DeniseViltes/dce-g5-proyecto_integrador/Checkpoint 2/DCE - PCB - v1/PLACA.jpeg

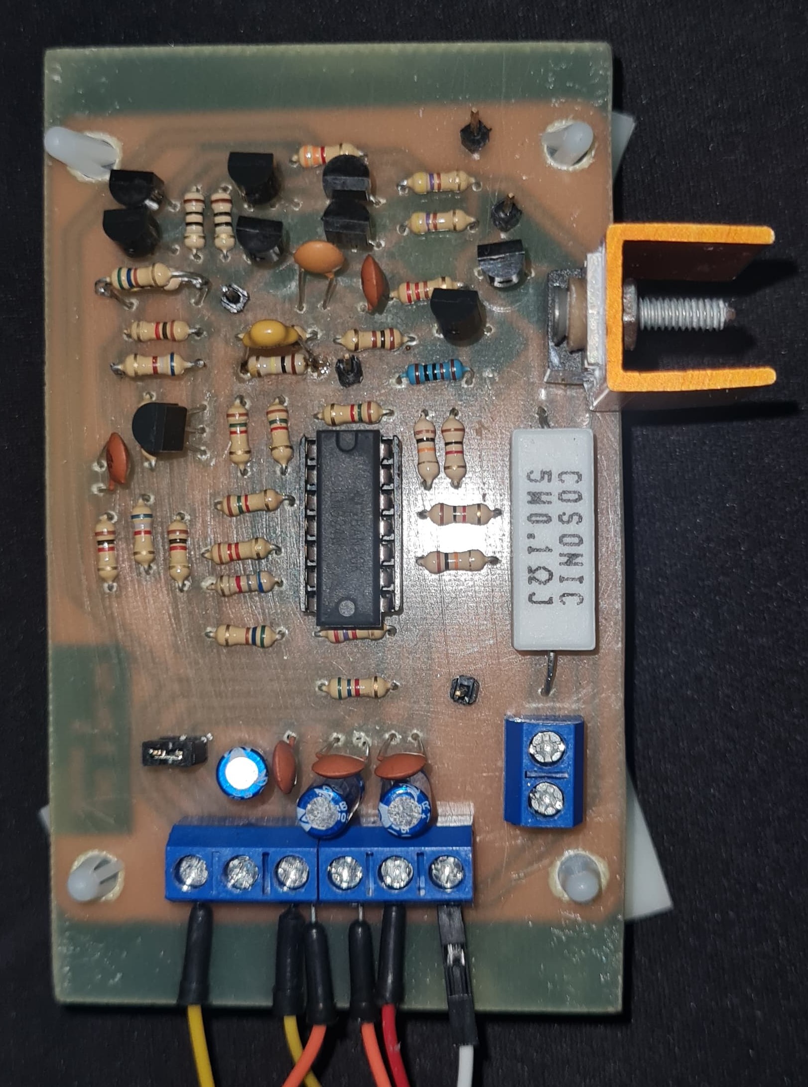
Checkpoint 2/DCE - PCB - v1/PLACA.jpeg
