DeniseViltes/dce-g5-proyecto_integrador/Checkpoint 2/Imagenes/pcb_front.png

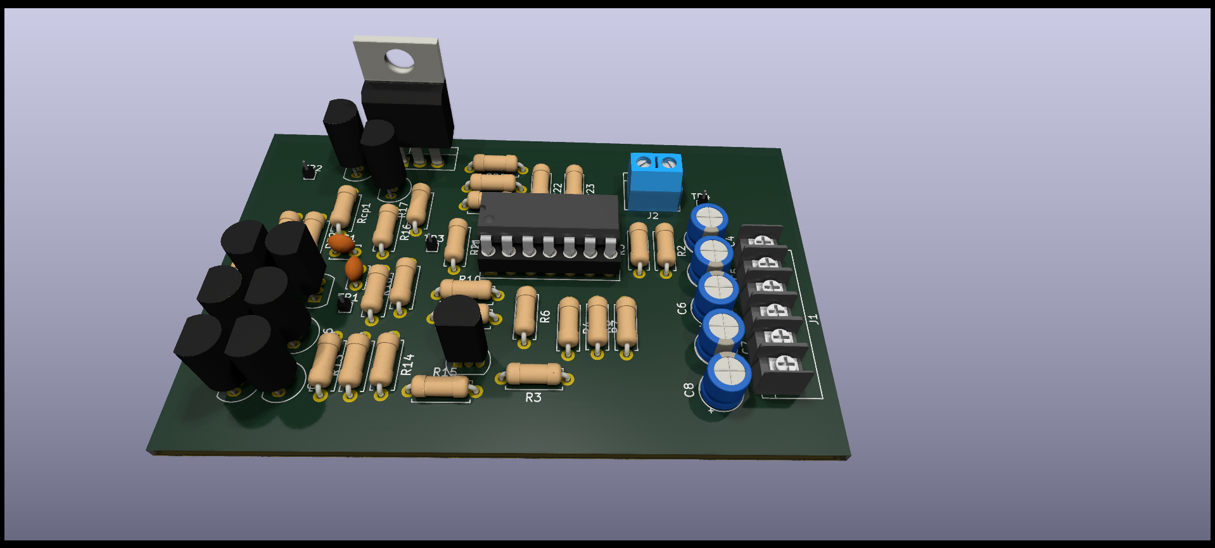
Checkpoint 2/Imagenes/pcb_front.png
