DeniseViltes/dce-g5-proyecto_integrador/README.md

# Proyecto de diseño: Sistema de alimentación para aplicaciones industriales y automotrices
>[!TIP]
>holaa
## Grupo 5
