DeniseViltes/dce-g5-proyecto_integrador/Checkpoint 1/Checkpoint_1_DCE.pdf

TA138 - Diseño de Circuitos Electrónicos | UBA - Facultad de Ingeniería

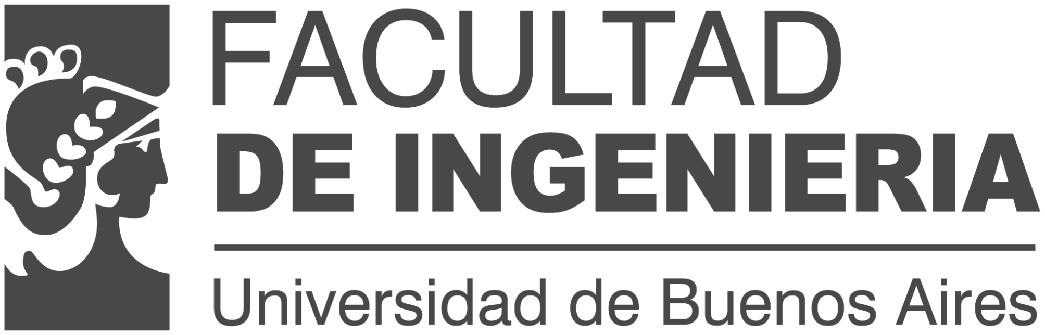
[picture p3: figure]

Departamento de Electronica ´
2

### do cuatrimestre de 2024

### Taller de Diseño de Circuitos Electrónicos (TA138) Checkpoint 1

Grupo | Alumno | Padrón | Mail

5

Diógenes Cornejo Zuviría | 106413 | dcornejoz@fi.uba.ar
Sebastián Ezequiel García | 103780 | sebgarcia@fi.uba.ar
Joaquín Mellibovsky | 103815 | jmellibovsky@fi.uba.ar
Denise Oriana Viltes | 106943 | dviltes@fi.uba.ar

TA138 - Diseño de Circuitos Electrónicos | UBA - Facultad de Ingeniería

## 1. Diseño del circuito

### 1.1. Especificaciones generales

La premisa principal del Trabajo Práctico es diseñar un circuito que se lo alimente con un amplio rango de tensiones de entrada pero que la salida sea de 5 V o 3,3 V según se seleccione. Además de este requisito para la tensión de salida, la corriente debe encontrarse siempre entre los 500 mA y los 750 mA. Las demás especificaciones se presentarán a medida que se desarrolle el circuito para cumplirlas.

En la figura 1 se muestra el diagrama en bloques del circuito a diseñar. En esta entrega nos enfocaremos en el diseño y el esquemático del PCB del bloque LDO.

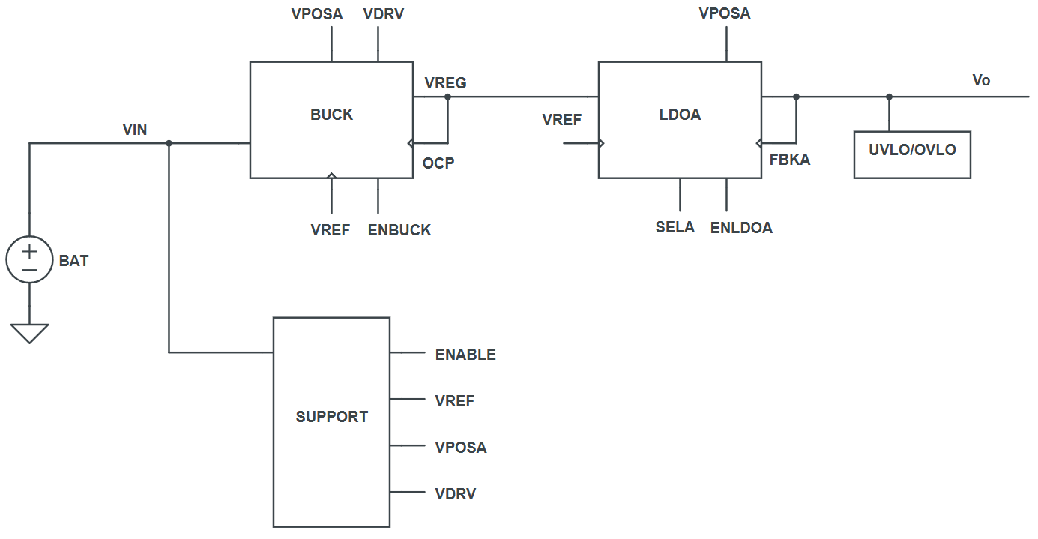
[picture p4: figure]

Figura 1: Diagrama en bloques funcionales del circuito a diseñar.

El bloque LDO recibe seis tensiones:

Vreg: Tensión de alimentación de los transistores del par diferencial, carga activa, fuente espejo y de paso.

Vref : Tensión de entrada al par diferencial.

VPOSA: Tensión de alimentación de los amplificadores operacionales.

2

TA138 - Diseño de Circuitos Electrónicos | UBA - Facultad de Ingeniería

SELA: Tensión de selección de la salida. Cuando está encendida, la salida es de 5 V, mientras que cuando está apagada es de 3,3 V.

FBKA: Realimentación mediante la implementación de un foldback.

ENLDOA: Tensión de encendido del bloque LDO.

El diagrama en bloques del LDO se muestra en la figura 2. En este dibujo los bloques de Muestreo de Corriente, Sumador y Comparador corresponden al foldback. A su vez, éstos y el feedback son todos juntos la realimentación.

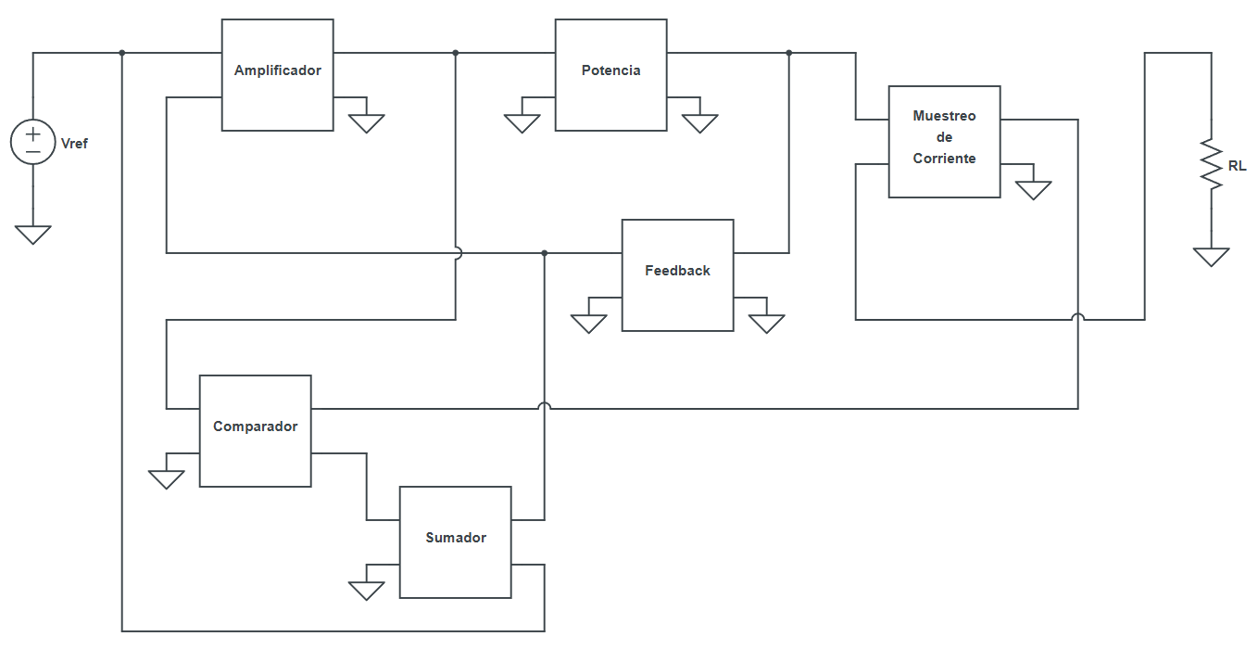
[picture p5: figure]

Figura 2: Diagrama en bloques del LDO.

### 1.2. Análisis de bloques

### 1.2.1. Par diferencial

En esta etapa se busca obtener un circuito estable con desapareamientos mínimos, logrando a su vez la mayor amplificación posible. En principio se parte de la idea de tener los transistores perfectamente apareados por lo que al momento de elegir los transistores, se buscan complementarios NPN-PNP.

Ya que la siguiente etapa (1.2.2) tiene como máximo ganancia unitaria, se debe

buscar maximizar la ganancia en esta etapa. Para lograr esto, en vez de utilizar

3

TA138 - Diseño de Circuitos Electrónicos | UBA - Facultad de Ingeniería

carga resistiva en cada rama del diferencial, se opta por agregar una carga activa, en este caso, una fuente espejo simple. Con esta modificación se logra aumentar la resistencia de salida del par diferencial, e incluso, mejorar el apareamiento del circuito al imponer la misma corriente en ambas ramas. Teniendo esto en cuenta, se buscan transistores con una VA alta (mejorando así la ro), y un β grande para lograr

maximizar la amplificación del par diferencial para la configuración elegida.

Siguiendo la misma línea de pensamiento, con el fin de obtener un circuito más estable, se polariza el diferencial con una fuente de corriente. Utilizando una fuente espejo simple que implica una mayor impedancia, se logra que mejore la relación de rechazo de modo común, sin afectar la ganancia del diferencial.

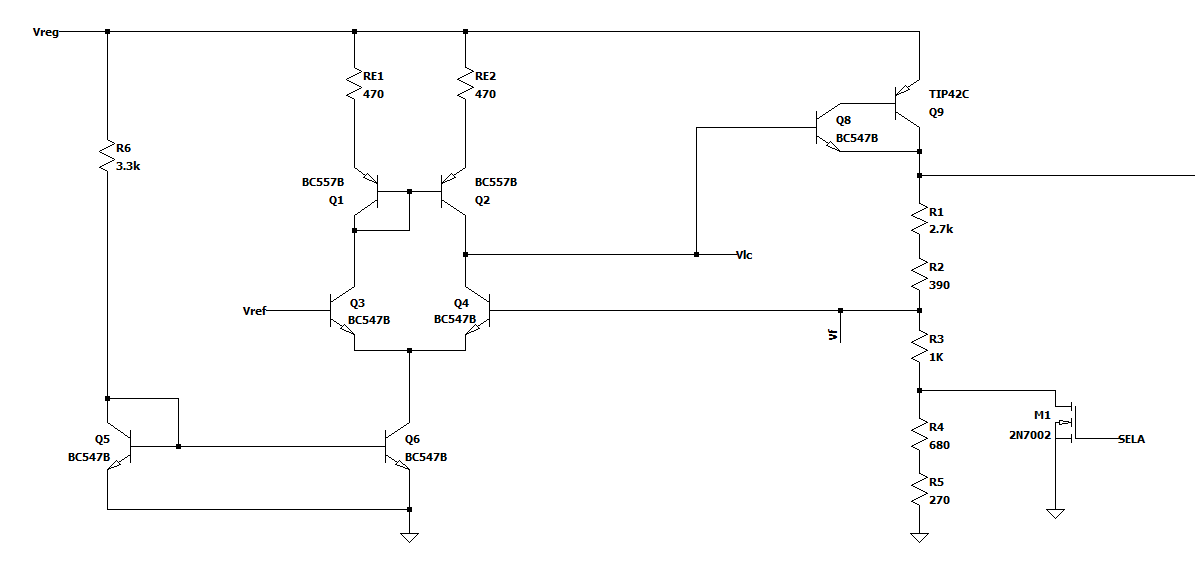
[picture p6: figure]

Figura 3: Bloque amplificador del circuito.

### 1.2.2. Etapa de potencia

A la salida single ended del par diferencial se conecta un par de transistores de paso en configuración cuasi-darlington tipo N. Para esta etapa se utiliza un transistor NPN TIP41C y uno PNP TIP42C. Estos transistores tienen la ventaja de tener una tensión de Early (VA) muy alta, lo cual implica que la tensión VCE varía muy poco con

la corriente como se ve en la figura 4, permitiendo entregarle la corriente necesaria a la carga sin variar la tensión de salida.

4

TA138 - Diseño de Circuitos Electrónicos | UBA - Facultad de Ingeniería

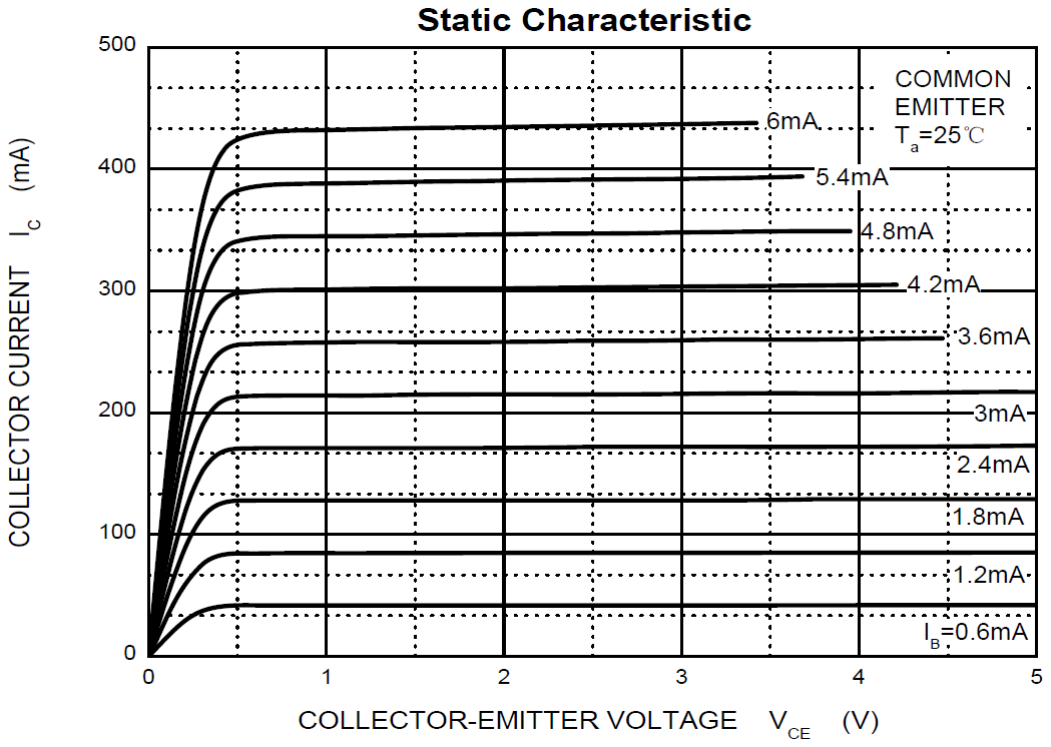
[picture p7: figure]

Figura 4: Curva de IC respecto de V ce para los transistores TIP41 y TIP42.

En cuanto a la configuración, se opta por un Darlington ya que a la salida de este regulador se espera una corriente de trabajo de 500 mA, pero en la salida del par diferencial se obtiene una corriente mucho menor. Esta configuración permite aumentar la corriente de salida del par diferencia β

2 veces.

### 1.2.3. Bloque realimentador

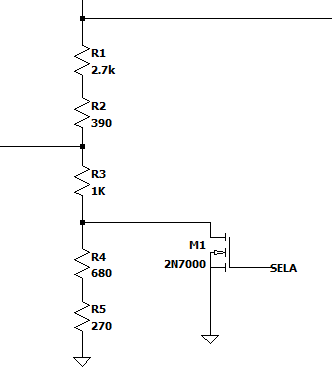
[picture p8: figure]

Figura 5: Bloque de realimentación.

A la salida del transistor de potencia, además de la carga y el bloque controlador de corriente, se coloca un divisor resistivo que muestrea parte de la tensión de salida

5

TA138 - Diseño de Circuitos Electrónicos | UBA - Facultad de Ingeniería

y la suma a la entrada del par diferencial. Idealmente el divisor resistivo debe lograr que se sume una tensión lo más parecida posible a Vref . Esta configuración cuenta con un N-MOSFET que se encarga de adaptar la impedancia para obtener 3,3 V o 5 V según corresponda. Cuando la entrada SELA del LDO supera la tensión VT

∼= 1 V

del transistor, éste entra en saturación y habilita un camino de menor impedancia que los resistores.

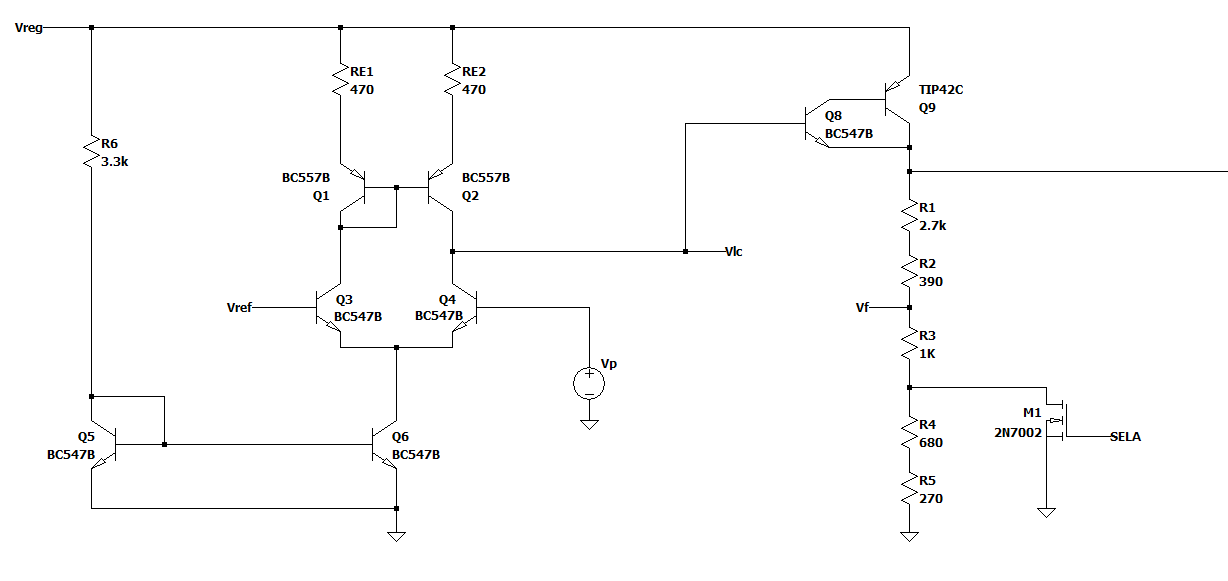
[picture p9: figure]

Figura 6: Esquemático del calculo teórico de la ganancia a lazo abierto a.

Dado entonces que el amplificador está realimentado, la ganancia del mismo a lazo cerrado va a estar dada por la siguiente ecuación:

A =

a
1 + a · f

Realizando los cálculos teóricos la ganancia del par diferencial se puede expresar como:

Para Vo = 3,3 V : avd =

gm4 · [ro2//(rπDar + βDar · (5 kΩ//RL)] 2

Para Vo = 5 V : avd =

gm4 · (ro2//(rπDar + βDar · (4,09 kΩ//RL)] 2

6

TA138 - Diseño de Circuitos Electrónicos | UBA - Facultad de Ingeniería

Se ve que la ganancia por lo tanto depende del valor de RL. En el mejor de los casos RL → ∞, es decir, se abre el circuito. Además, como βdar es muy grande (aproximadamente 4000), mientras el LDO regula tensión la ganancia a lazo abierto

es igual para ambas tensiones de salida.

avd ∼=

gm4 · ro2
2

Considerando los siguientes valores de reposo, los parámetros de señal del amplificador diferencial y del transistor de paso resultan:

Parámetros de Señal

| Icq | gm | rπ | ro
Q1,2,3,4 | 0,85 mA | 34 mA V | 8,5 kΩ | 118 kΩ
Q5,6 | 1,7 mA | 68 mA V | 4,2 kΩ | 59 kΩ

Con estos valores y teniendo en cuenta que la ganancia de la etapa de potencia es aproximadamente unitaria (por su configuración equivalente en colector común) la

ganancia del LDO sin realimentar es:

av = 2006

Cuando la tensión SELA está desactivada (Vo = 3,3 V) la ganancia del bloque

realimentador está dada por el siguiente divisor resistivo:

f =

Vf
Vo

=

270 Ω + 680 Ω + 1 kΩ
270 Ω + 680 Ω + 1 kΩ + 390 Ω + 2,7 kΩ = 0,39

a · f = 2006 · 0, 39 = 782

En cambio, cuando la tensión SELA se activa (Vo = 5 V), se habilita el MOSFET pasa a actuar en tríodo (por la baja corriente que lo circula), por lo que su caída de tensión (VDS) es muy pequeña y resulta aproximadamente el siguiente divisor:

7

TA138 - Diseño de Circuitos Electrónicos | UBA - Facultad de Ingeniería

f =

Vf
Vo

=

1 kΩ
1 kΩ + 390 Ω + 2,7 kΩ = 0, 244

a · f = 2006 · 0, 244 = 489

Finalmente, sabiendo que a · f ≫ 1 se puede aproximar entonces la ganancia del

LDO a lazo cerrado como
A ∼=

1
f

Para Vo = 3,3 V : A ∼=

1
f

= 2, 56

Vo

∼= A · Vref ∼= 3,3 V

Para Vo = 5 V : A ∼=

1
f

= 4,09

Vo

∼= A · Vref ∼= 5 V

8

TA138 - Diseño de Circuitos Electrónicos | UBA - Facultad de Ingeniería

### 1.2.4. Muestreo de corriente

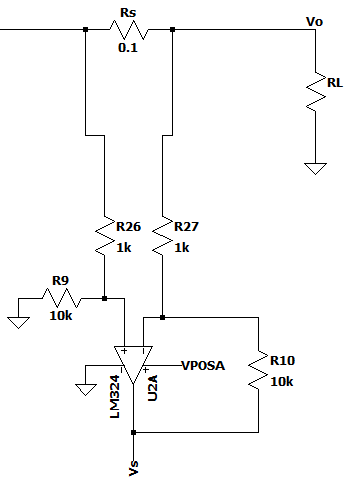
[picture p10: figure]

Figura 7: Muestreo de corriente y salida.

Se diseña el bloque de muestreo de tensión como se muestra en la figura 7. Se elige una Rs de 0,1 Ω, cuya caída de tensión es tomada por un opamp con ganancia de 10. De esta forma, se puede traducir la corriente que circula en dicho resistor a una tensión que se pueda comparar con una referencia en el siguiente bloque. Esta etapa se compara contra la tensión de referencia en el bloque comparador con el fin de limitar la corriente para no superar los 750 mA.

9

TA138 - Diseño de Circuitos Electrónicos | UBA - Facultad de Ingeniería

### 1.2.5. Referencia de tensión

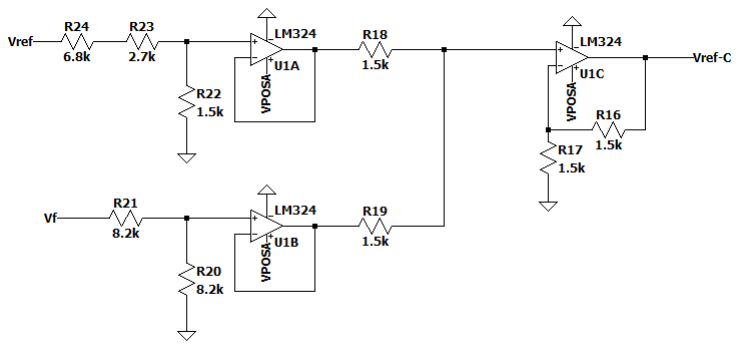
[picture p11: figure]

Figura 8: Bloque de referencia de tensión.

Se usan tres opamps para establecer una tensión de referencia que se pueda comparar con la tensión traducida de la corriente sobre la carga. La entrada de Q3 es fija: Vref y mediante un divisor resistivo se la redujo a 200 mV. Esta corresponde a ´

la corriente mínima que se pide que circule por la carga. A su vez, se tomó la tensión de entrada del otro transistor Q4, la cual es la tensión de feedback Vf . Esta tensión tiene un valor máximo de 1,2 V, por lo que el divisor resistivo a la entrada del opamp U1B es tal que la tensión máxima que reciba sea de 500 mV. Luego, el opamp U1C suma estas dos tensiones, por lo que la salida variaría entre 200 mV y 750 mV. Esto ocurriría idealmente pero los componentes no lo son y hay que tener en cuenta los desapareamientos de los transistores de los opamps que afectan a la ganancia. Esto implica que los seguidores no se comportan como tales, sino que incrementan la entrada. Para compensar esto, la rama que toma la tensión de Vref no se la reduce a 200 mA sino a un valor un poco menor. De igual forma, en la rama que toma la tensión se aumentó el valor de la entrada al opamp. Con estos valores se llega a las corrientes de salida máxima y mínima pedidas.

10

TA138 - Diseño de Circuitos Electrónicos | UBA - Facultad de Ingeniería

### 1.2.6. Comparador

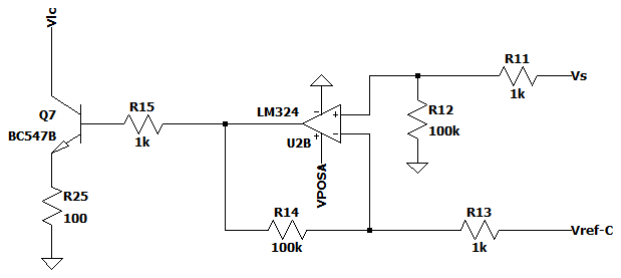
[picture p12: figure]

Figura 9: Bloque comparador y realimentación.

Este opamp (U2B) recibe las tensiones generadas por los dos bloques mencionados

anteriormente y se encarga de compararlos. En su funcionamiento habitual el LDO regula tensión (3,3 V o 5 V estables a la salida) pero como protección se colocan estos últimos tres bloques que se encargan de limitar la corriente de salida a 750 mA como máximo. Este último opamp se encarga de generar una tensión de salida que ponga en MAD al transistor Q7 cuando la corriente a la salida intenta superar los 750 mA para que le reduzca la corriente a la base de transistor de paso y así controlar la corriente.

## 2. Simulación

### 2.0.1. Tensión de salida respecto a la carga

Con todas las consideraciones ya comentadas, se simula en LTspice la variación de tensión de salida respecto a la corriente sobre la carga como en la figura 10 mientras se varía el valor de RL. En este gráfico queda claro el efecto del foldback. La tensión de salida es constante, por lo que la corriente en la carga debe aumentar mientas más chica es esta impedancia. Sin embargo, cuando la resistencia es tan chica que

11

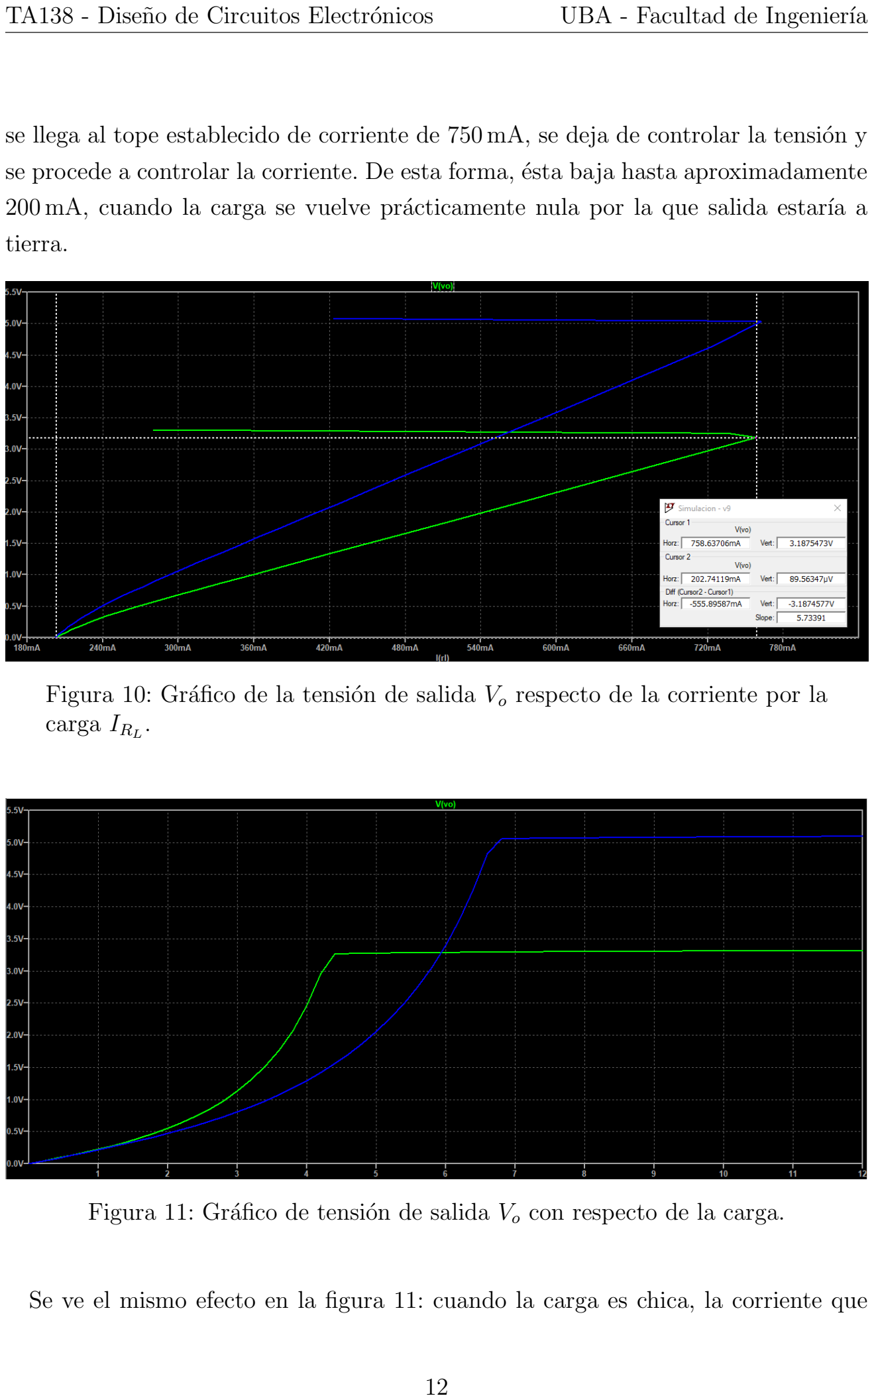
[picture p13: page 12]

TA138 - Diseño de Circuitos Electrónicos | UBA - Facultad de Ingeniería

se llega al tope establecido de corriente de 750 mA, se deja de controlar la tensión y se procede a controlar la corriente. De esta forma, ésta baja hasta aproximadamente 200 mA, cuando la carga se vuelve prácticamente nula por la que salida estaría a tierra.

Figura 10: Gráfico de la tensión de salida Vo respecto de la corriente por la carga IRL

Figura 11: Gráfico de tensión de salida Vo con respecto de la carga.

Se ve el mismo efecto en la figura 11: cuando la carga es chica, la corriente que

12

TA138 - Diseño de Circuitos Electrónicos | UBA - Facultad de Ingeniería

la atraviesa es grande, por lo que se controla la corriente, provocando variaciones en la tensión. Pero luego, cuando se llega al valor de tensión de salida establecido, se deja de controlar la tensión y se procede a controlar la tensión. En el gráfico se aprecia como la salida se torna constante. Esto ocurre aproximadamente a partir de los 4,5 Ω cuando la salida es 3,3 V y 6,6 Ω cuando se tiene una Vo = 5 V.

### 2.0.2. Tensión de salida respecto de la tensión de entrada

A su vez, también se tiene la recta de línea. Esta corresponde a la variación de ´

la tensión de salida versus la tensión de alimentación. Como se puede ver en la figura 12, la salida es estable, con una variación insignificante ante los cambios en la entrada.

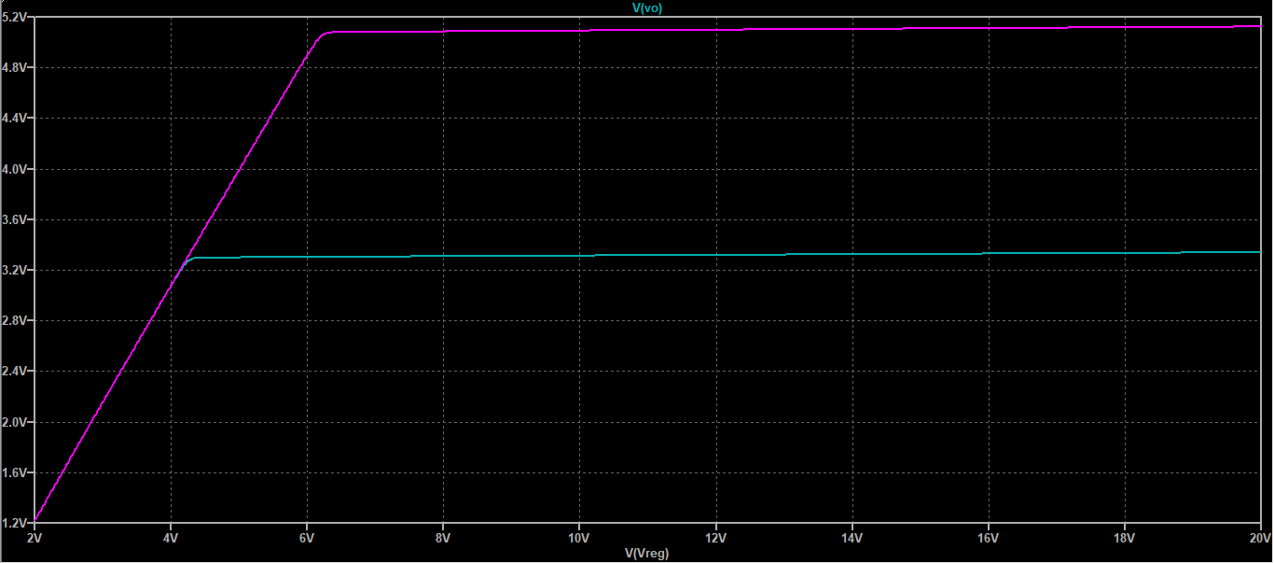
[picture p14: figure]

Figura 12: Gráfico de la tensión de salida Vo respecto a la variación de tensión

Vreg.

### 2.0.3. Ganancia de lazo

Para simular la ganancia de lazo T, se abre el lazo de realimentación con un inductor y un capacitor de gran impedancia, como se observa en la figura 13. De esta forma se logra romper el lazo en señal, pero sin afectar la polarización del circuito. Por otro lado, al igual que en los cálculos teóricos, el mejor caso se obtiene tomando RL → ∞, por lo tanto se realiza la simulación a circuito abierto.

13

TA138 - Diseño de Circuitos Electrónicos | UBA - Facultad de Ingeniería

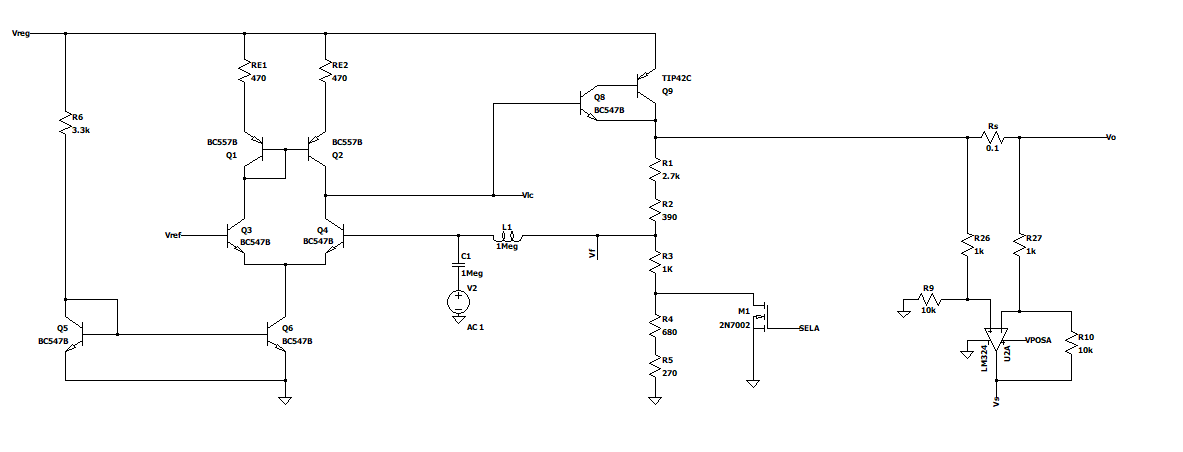
[picture p15: figure]

Figura 13: Esquemático de la simulación de lazo T.

Como se observa en la figura 14 se obtiene una ganancia de 57 dB para Vo = 3,3 V y 53 dB para Vo = 5 V, es decir una ganancia de T = 708 y T = 447 respectivamente siendo estos similares a los calculados previamente en la sección 1.2.3.

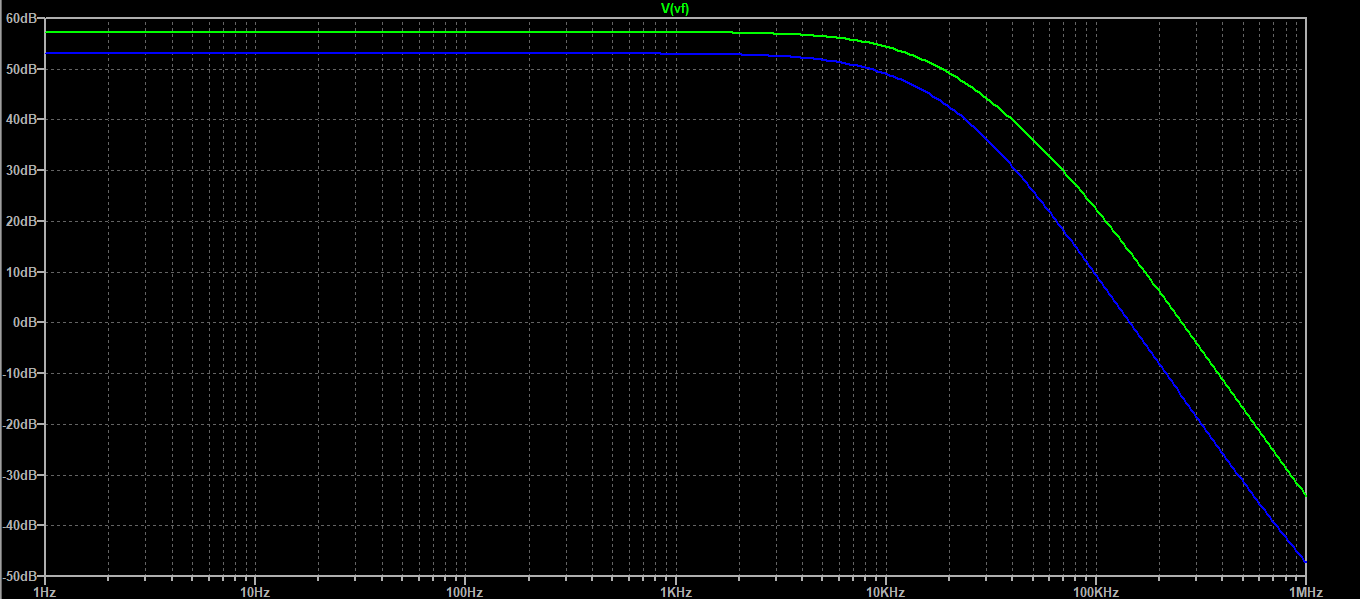
[picture p16: figure]

Figura 14: Simulación de la ganancia de lazo.

Por otro lado, se analiza el peor caso posible para verificar que el amplificador funciona correctamente incluso para valores bajos de la carga. Se extraen esos valores de la figura 11: para la salida de 5 V, el mínimo valor de la carga para la región donde se regula la tensión es aproximadamente de 7 Ω. A su vez, esta impedancia

14

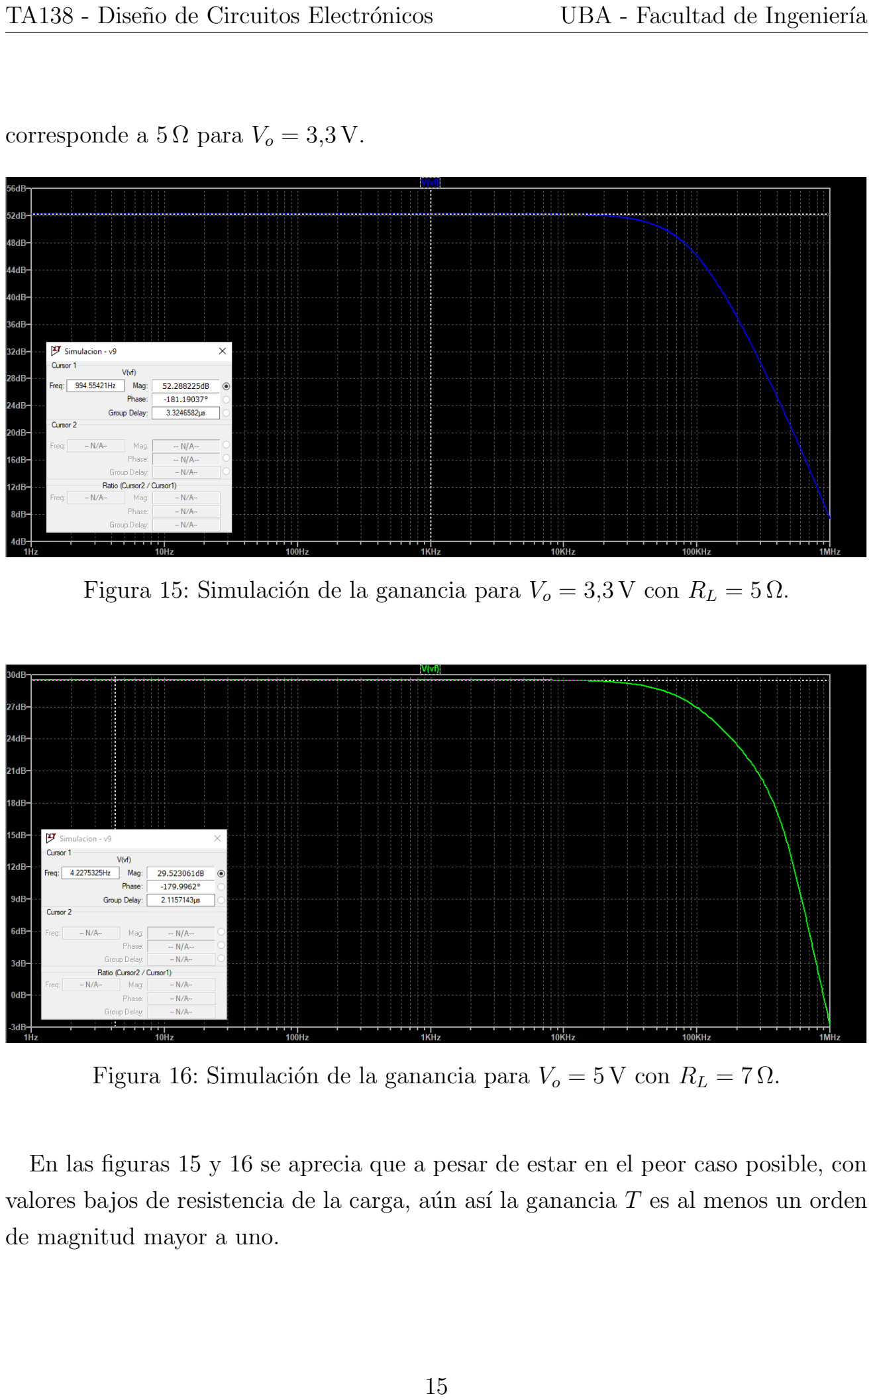
[picture p17: page 15]

TA138 - Diseño de Circuitos Electrónicos | UBA - Facultad de Ingeniería

corresponde a 5 Ω para Vo = 3,3 V.

Figura 15: Simulación de la ganancia para Vo = 3,3 V con RL = 5 Ω.

Figura 16: Simulación de la ganancia para Vo = 5 V con RL = 7 Ω.

En las figuras 15 y 16 se aprecia que a pesar de estar en el peor caso posible, con valores bajos de resistencia de la carga, aún así la ganancia T es al menos un orden de magnitud mayor a uno.

15

TA138 - Diseño de Circuitos Electrónicos | UBA - Facultad de Ingeniería

## 3. Esquemático del PCB

Para realizar el esquemático del PCB, es necesario modificar los símbolos de los operacionales considerando que en cada DIP hay cuatro opamps. Por esta razón utilizamos dos encapsulados LM324, teniendo en cuanta que los tres operacionales restantes se ponen en corto para evitar sobrecalentamiento en el encapsulado. Por otro lado, las fuentes de tensión se reemplazan por pines por los cuales se proporcionará la tensión esperada.

16

TA138 - Diseño de Circuitos Electrónicos | UBA - Facultad de Ingeniería

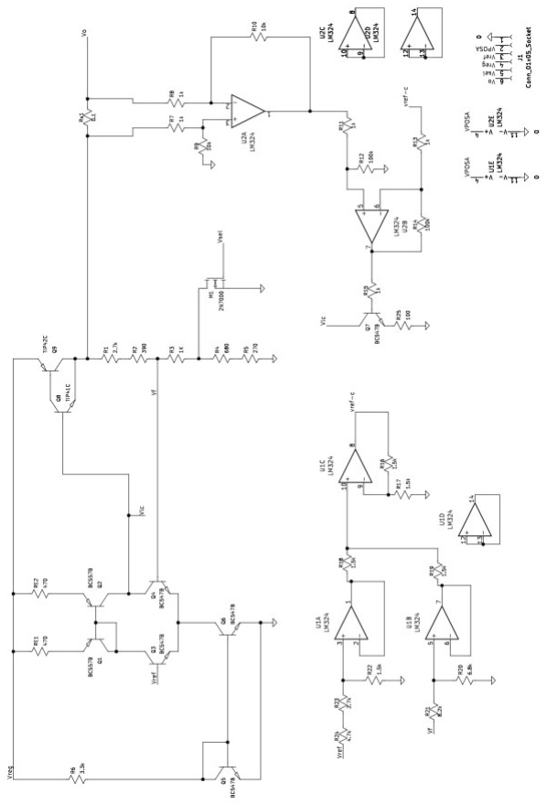
[picture p18: figure]

Figura 17: Esquemático del PCB

17
