DeniseViltes/dce-g5-proyecto_integrador/Checkpoint 4/Inductor/tablas utiles inductor.pdf

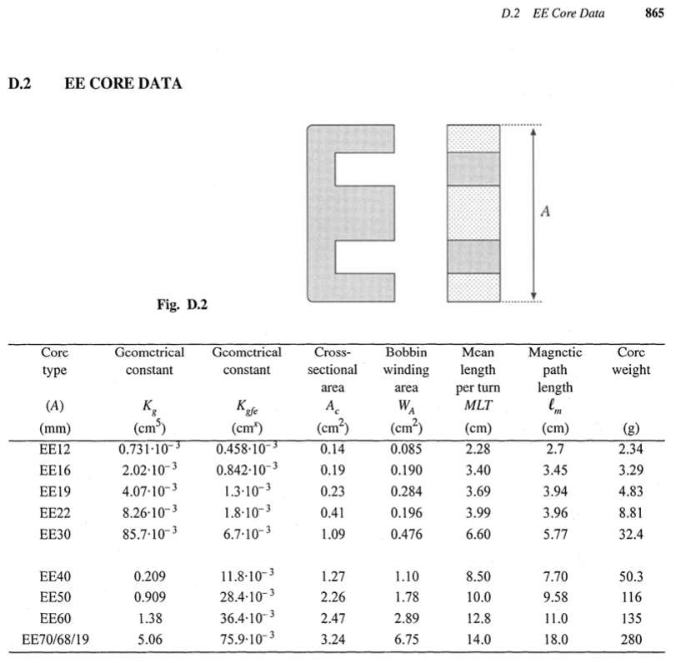
[picture p19: page 1]
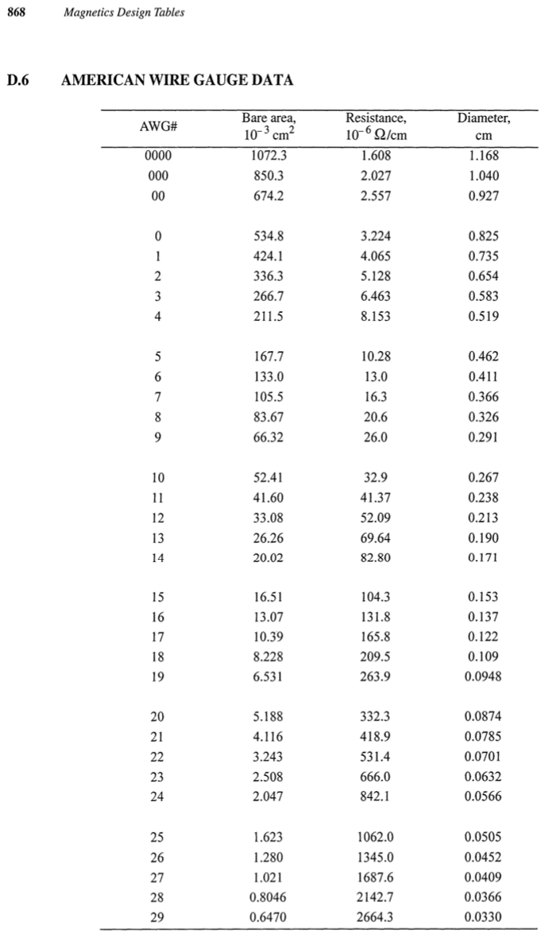
[picture p20: page 2]
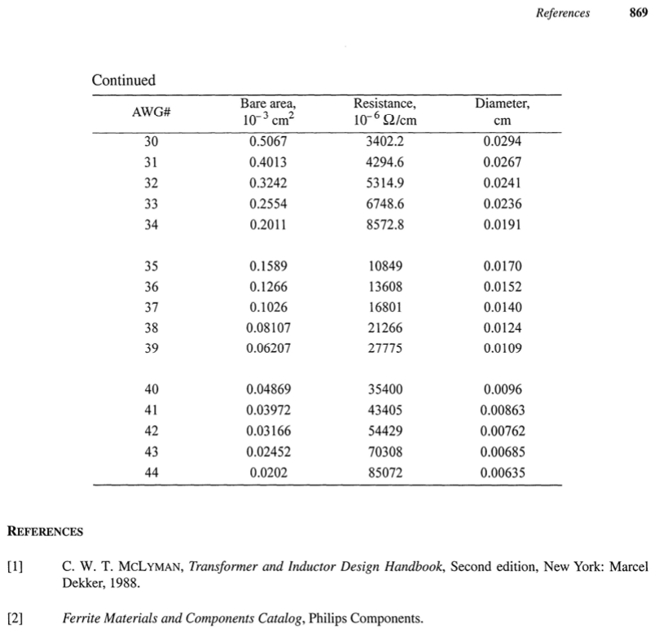
[picture p21: page 3]
