DeniseViltes/dce-g5-proyecto_integrador/Checkpoint 2/Capacitores Valores Comerciales.png

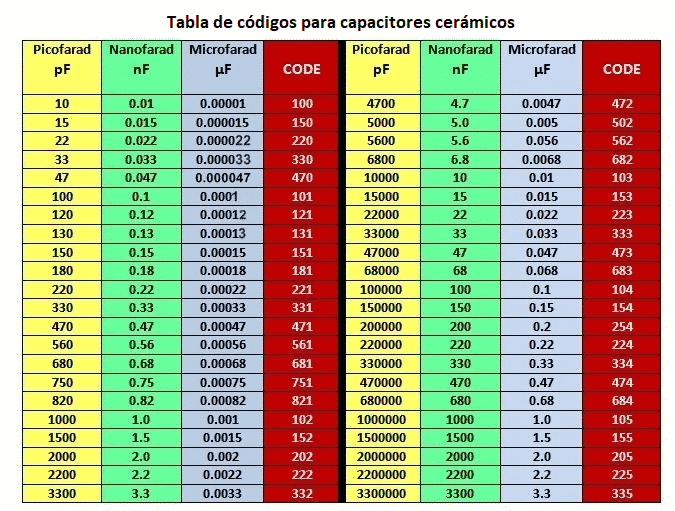
Checkpoint 2/Capacitores Valores Comerciales.png
