DeniseViltes/dce-g5-proyecto_integrador/Checkpoint 2/DCE - PCB - v1/Captura de pantalla 2024-10-05 203116.png

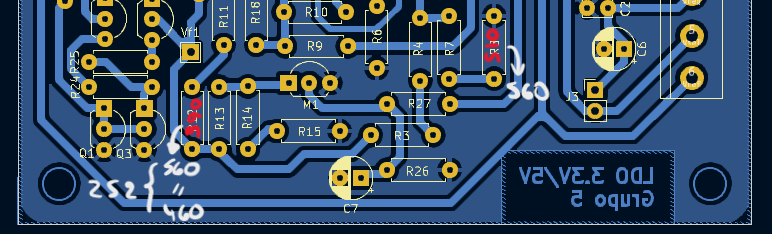
Checkpoint 2/DCE - PCB - v1/Captura de pantalla 2024-10-05 203116.png
