DeniseViltes/dce-g5-proyecto_integrador/Checkpoint 2/DCE - PCB - v1/pcb.png

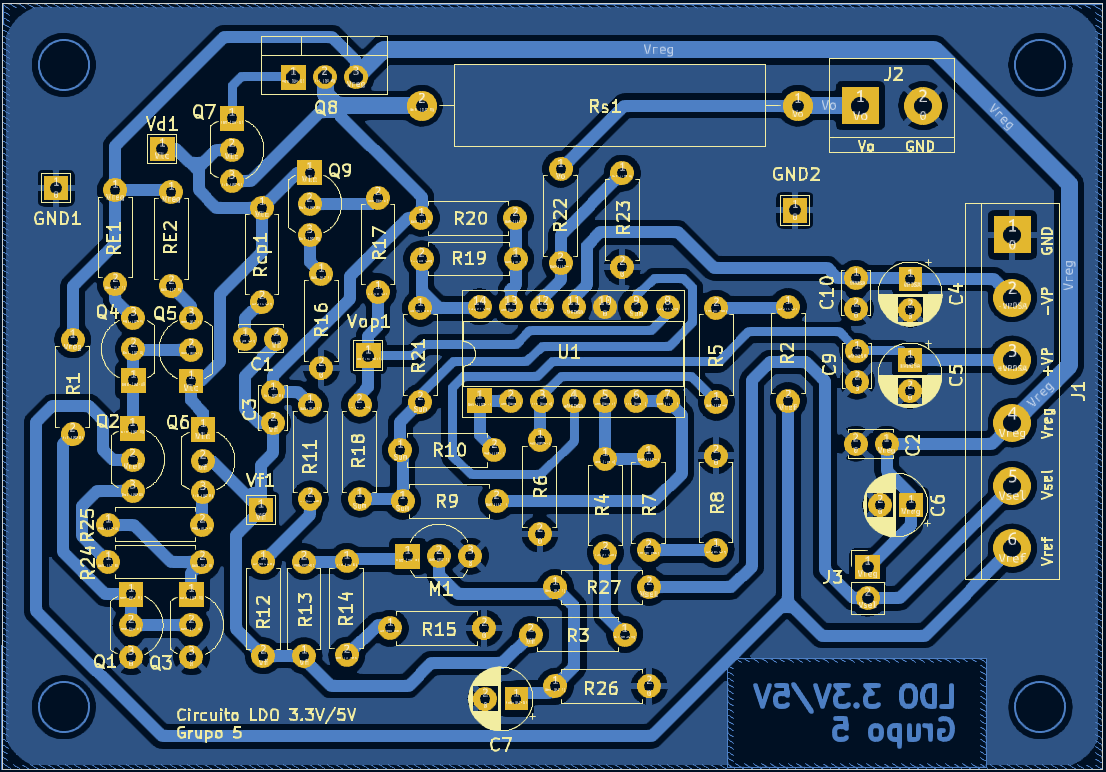
Checkpoint 2/DCE - PCB - v1/pcb.png
