DeniseViltes/dce-g5-proyecto_integrador/Checkpoint 2/Imagenes/Ic-Vce TIP.png

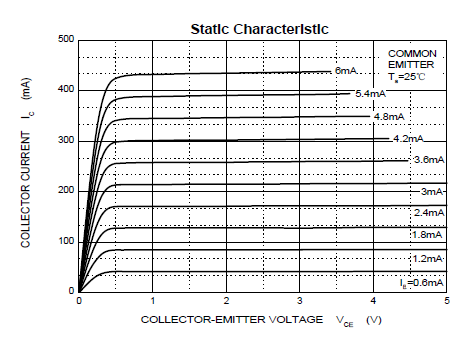
Checkpoint 2/Imagenes/Ic-Vce TIP.png
