DeniseViltes/dce-g5-proyecto_integrador/Checkpoint 2/Imagenes/pcb_back.png

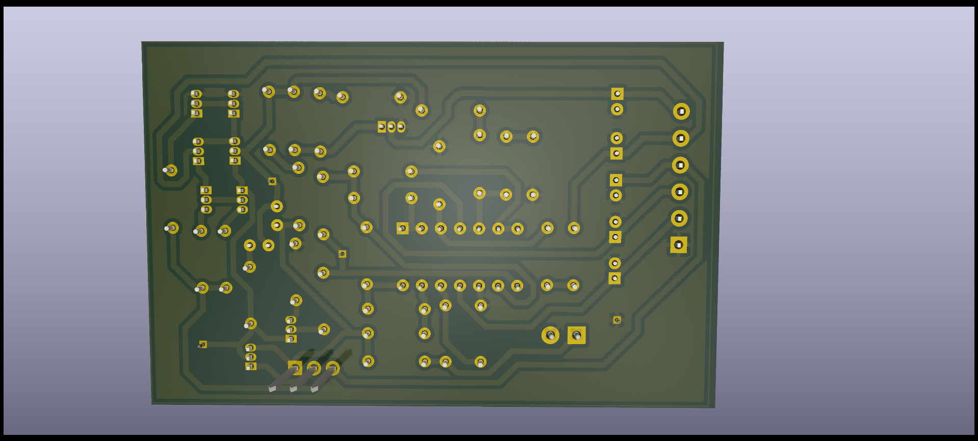
Checkpoint 2/Imagenes/pcb_back.png
