DeniseViltes/dce-g5-proyecto_integrador/Checkpoint 3/graficos/eficienca.png

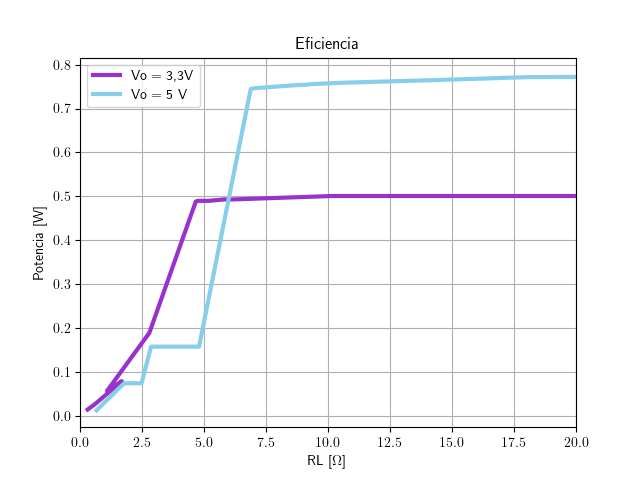
Checkpoint 3/graficos/eficienca.png
