DeniseViltes/dce-g5-proyecto_integrador/Checkpoint 3/graficos/potencia3.png

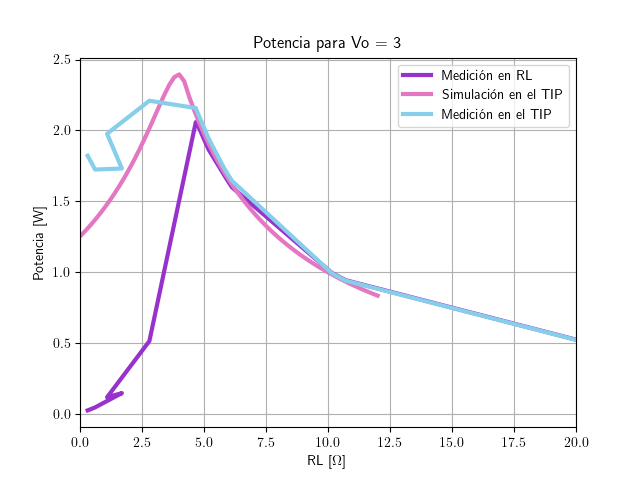
Checkpoint 3/graficos/potencia3.png
