DeniseViltes/dce-g5-proyecto_integrador/Checkpoint 3/graficos/Recta_de_linea.png

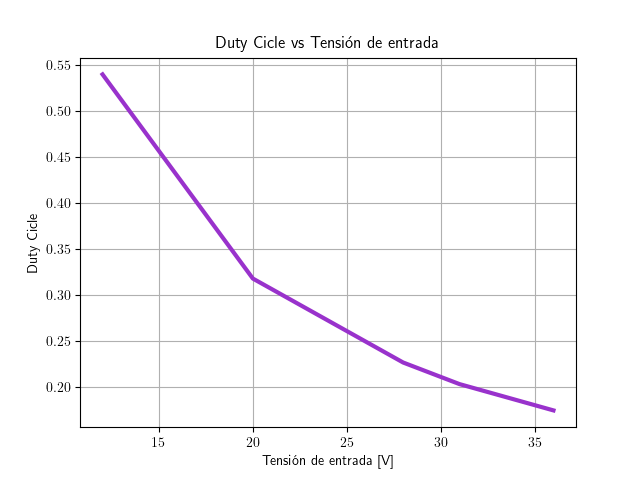
Checkpoint 3/graficos/Recta_de_linea.png
