DeniseViltes/dce-g5-proyecto_integrador/Checkpoint 3/graficos/rectasDeCarga3V.png

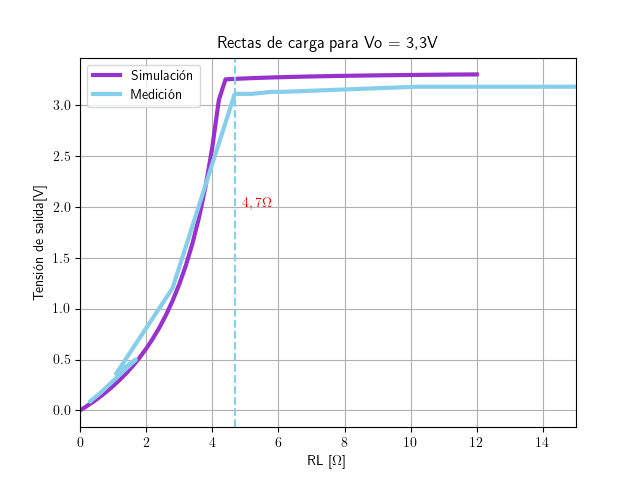
Checkpoint 3/graficos/rectasDeCarga3V.png
