DeniseViltes/dce-g5-proyecto_integrador/Checkpoint 3/graficos/rectasDeCarga5V.png

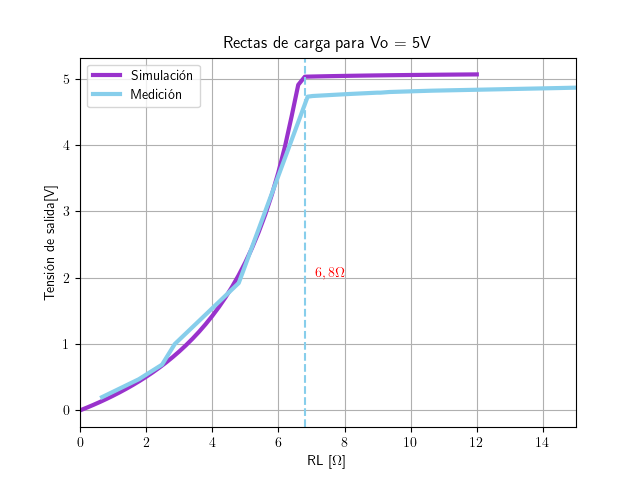
Checkpoint 3/graficos/rectasDeCarga5V.png
