DeniseViltes/dce-g5-proyecto_integrador/Checkpoint 3/graficos/rectasDeLinea5.png

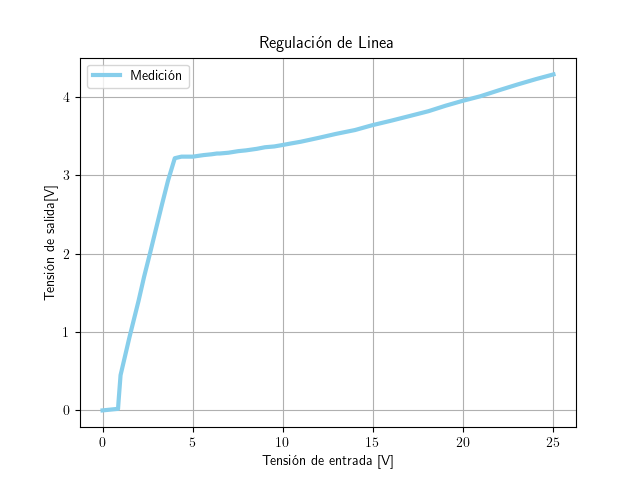
Checkpoint 3/graficos/rectasDeLinea5.png
