DeniseViltes/dce-g5-proyecto_integrador/Checkpoint 4/Imagenes/Buck-pcb.png

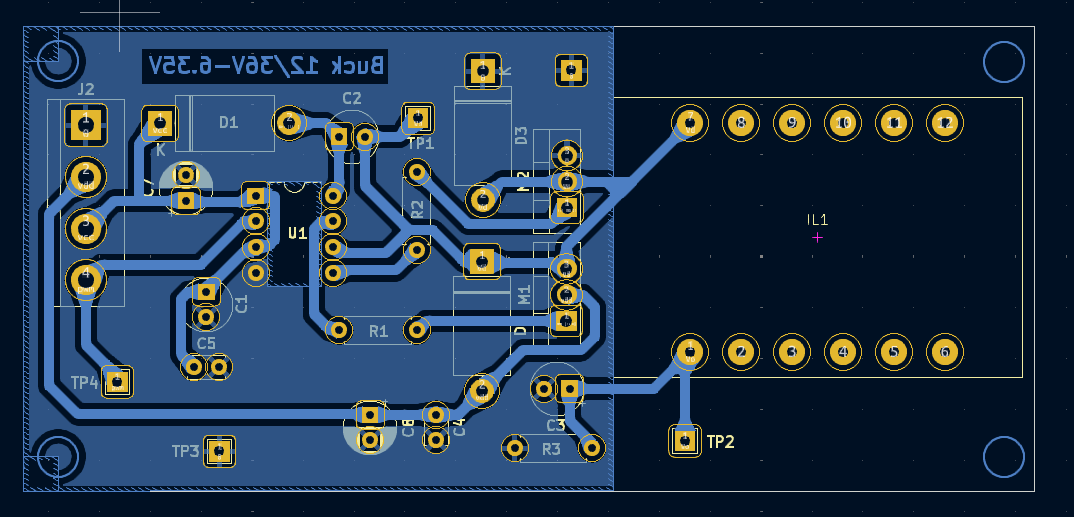
Checkpoint 4/Imagenes/Buck-pcb.png
