DeniseViltes/dce-g5-proyecto_integrador/Checkpoint 4/Imagenes/BuckSimu.png

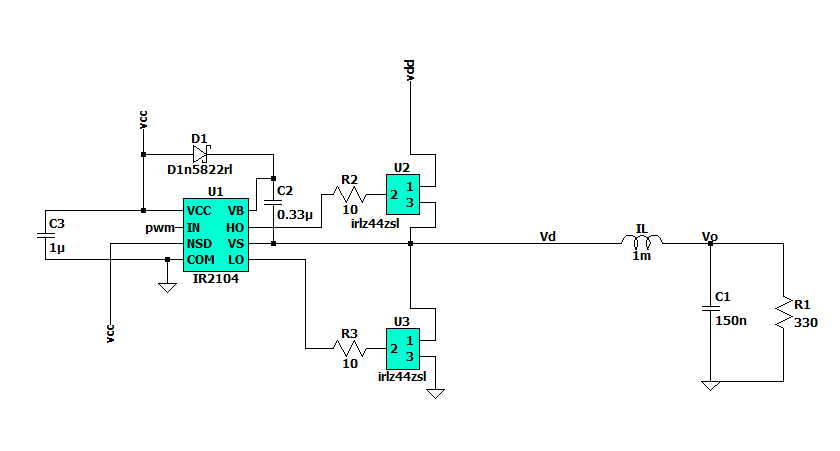
Checkpoint 4/Imagenes/BuckSimu.png
