DeniseViltes/dce-g5-proyecto_integrador/Checkpoint 4/Imagenes/circuitoSincrónico.png

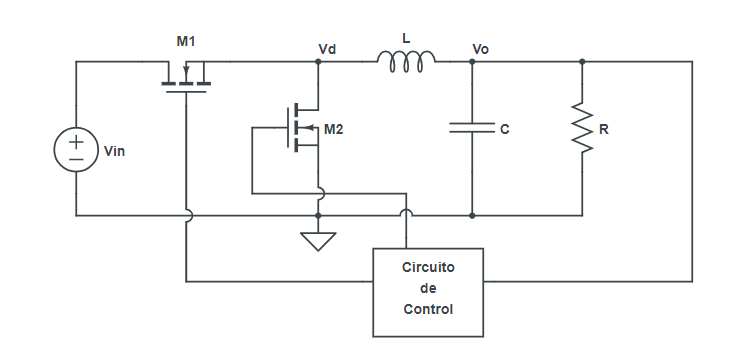
Checkpoint 4/Imagenes/circuitoSincrónico.png
