DeniseViltes/dce-g5-proyecto_integrador/Checkpoint 4/Imagenes/inductor.jpg

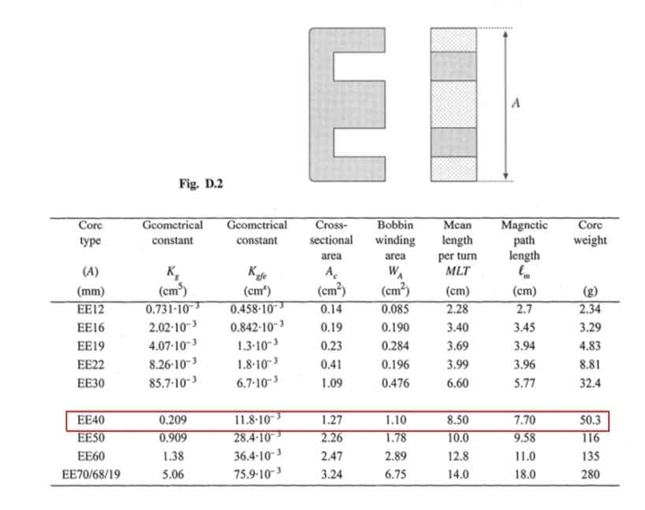
Checkpoint 4/Imagenes/inductor.jpg
