DeniseViltes/dce-g5-proyecto_integrador/Checkpoint 4/Imagenes/pwm-pcb.png

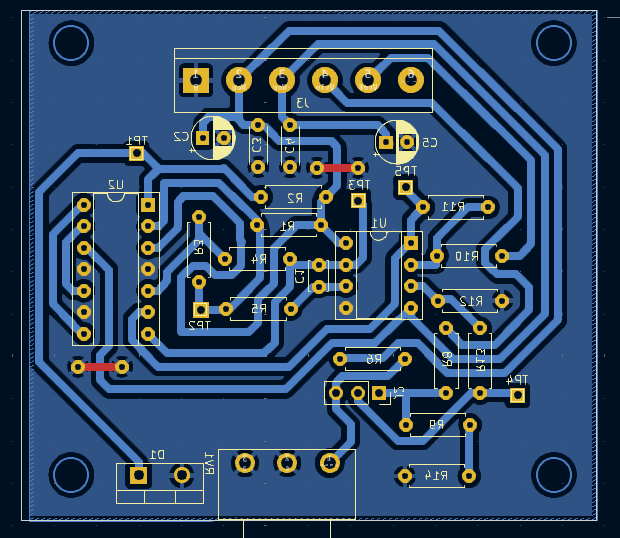
Checkpoint 4/Imagenes/pwm-pcb.png
