DeniseViltes/dce-g5-proyecto_integrador/Checkpoint 4/Imagenes/support-pcb.png

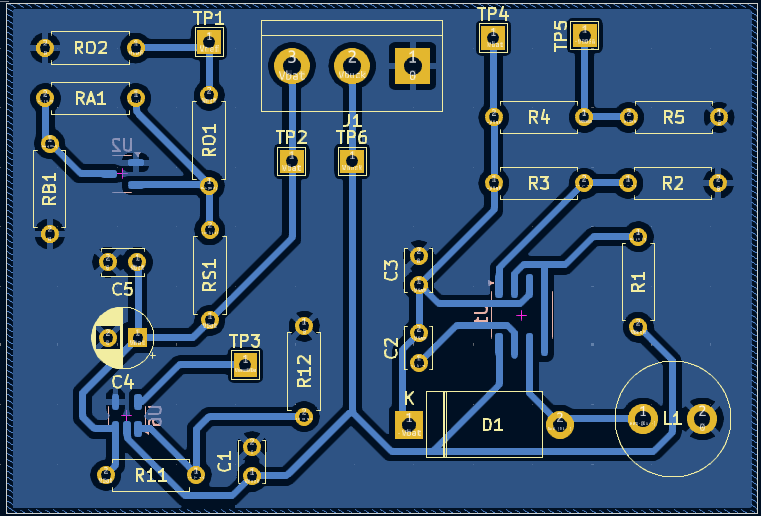
Checkpoint 4/Imagenes/support-pcb.png
