DeniseViltes/dce-g5-proyecto_integrador/Checkpoint 5/Buck-compensado/CompensacionVariasR.png

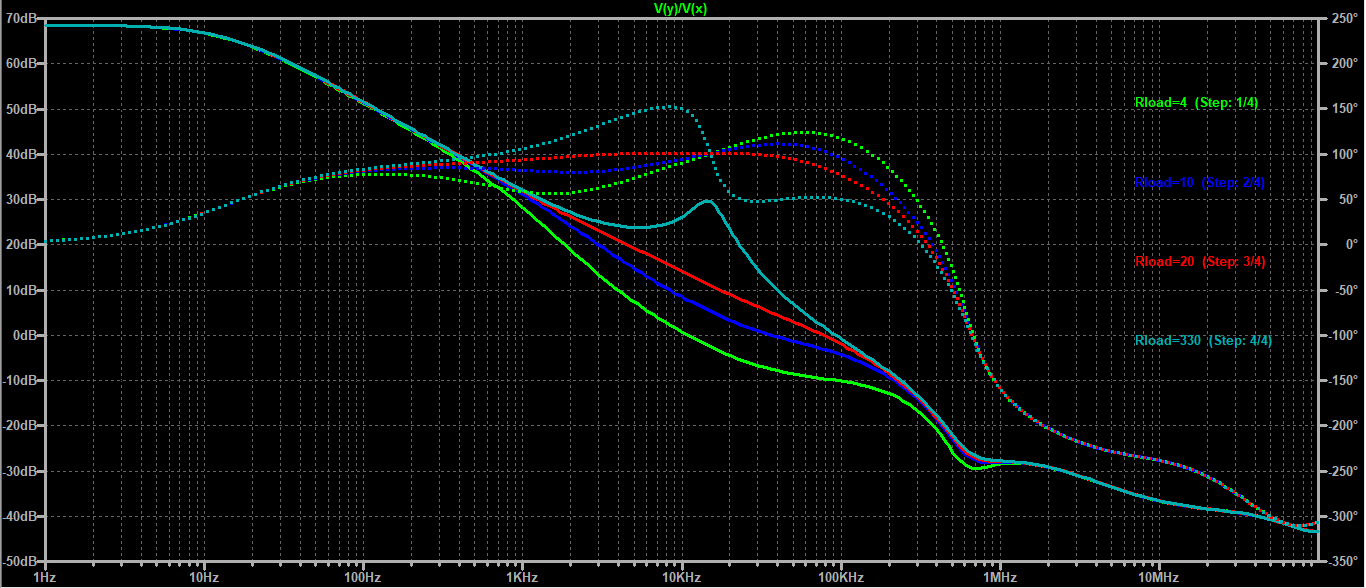
Checkpoint 5/Buck-compensado/CompensacionVariasR.png
