DeniseViltes/dce-g5-proyecto_integrador/Checkpoint 5/Buck-compensado/esquematico-buck-SinCompensado.png

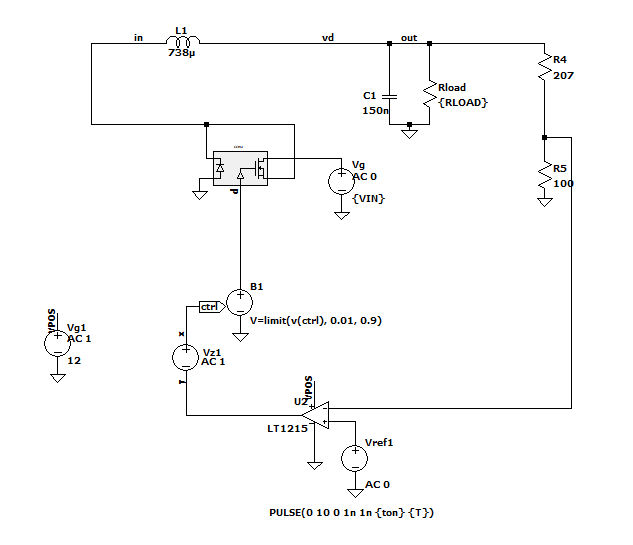
Checkpoint 5/Buck-compensado/esquematico-buck-SinCompensado.png
