DeniseViltes/dce-g5-proyecto_integrador/Checkpoint 5/Buck-compensado/esquematico-lazo-cerrado.png

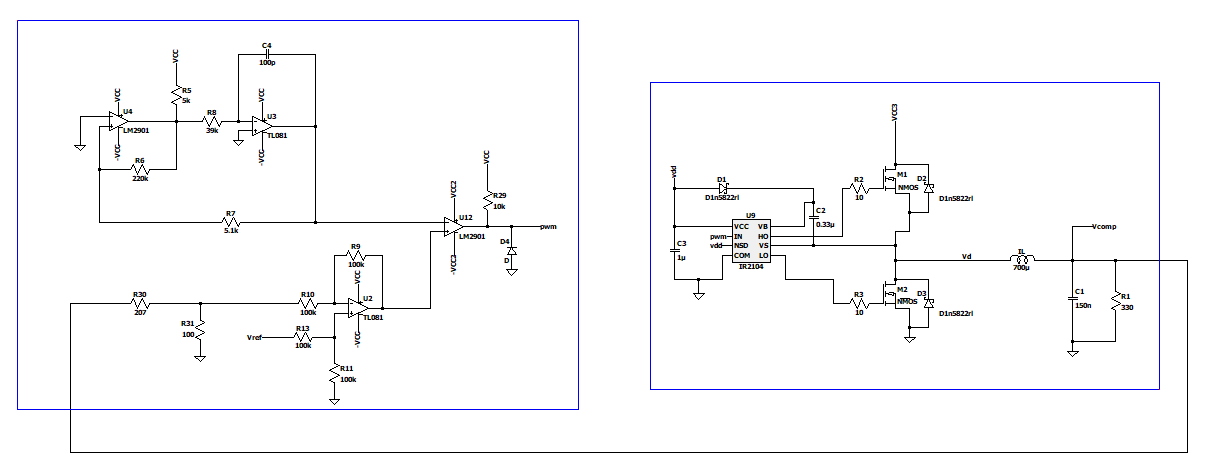
Checkpoint 5/Buck-compensado/esquematico-lazo-cerrado.png
