DeniseViltes/dce-g5-proyecto_integrador/Checkpoint 5/Inductor/Camscanner_1733517718912.jpg

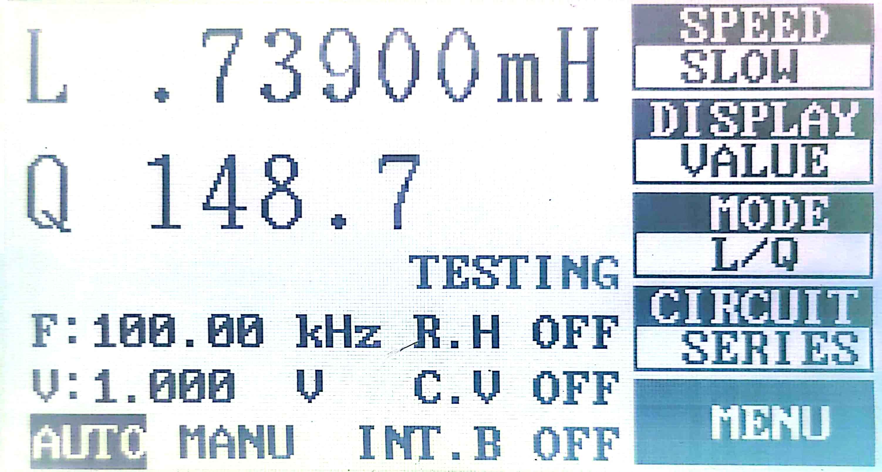
Checkpoint 5/Inductor/Camscanner_1733517718912.jpg
