DeniseViltes/dce-g5-proyecto_integrador/python/Buck/graficos/comparacinTransitorioAntesYDespues.png

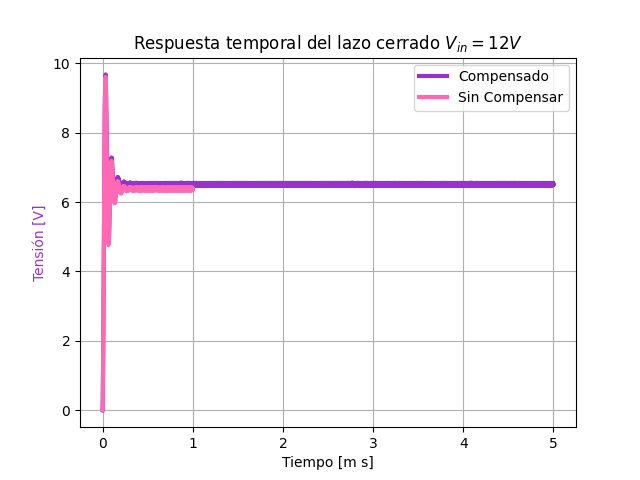
python/Buck/graficos/comparacinTransitorioAntesYDespues.png
