DeniseViltes/dce-g5-proyecto_integrador/python/Buck/graficos/corriente_buck.png

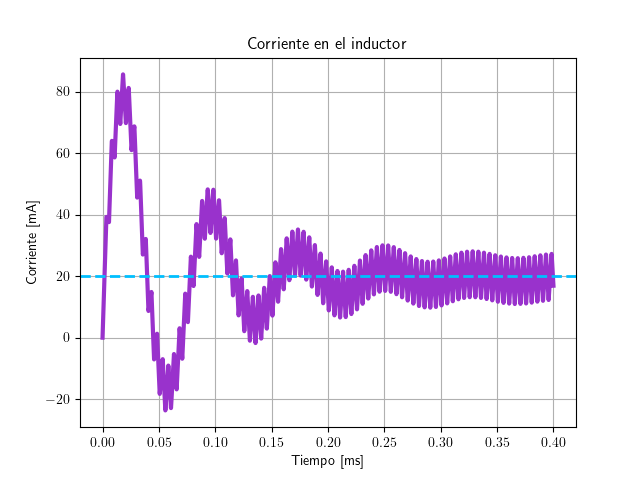
python/Buck/graficos/corriente_buck.png
