DeniseViltes/dce-g5-proyecto_integrador/python/Buck/graficos/corriente_buck_zoom.png

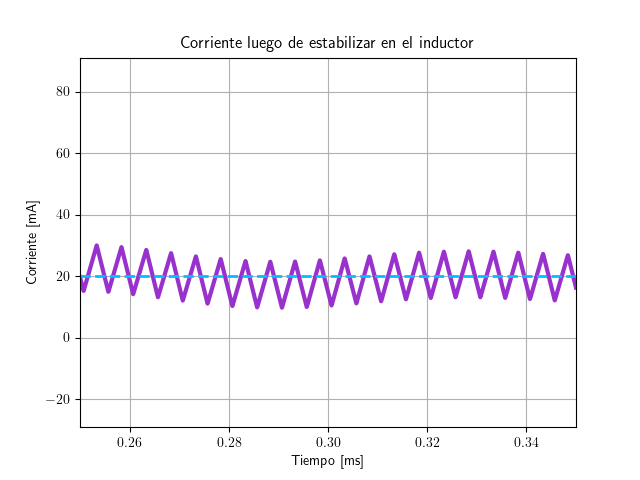
python/Buck/graficos/corriente_buck_zoom.png
