DeniseViltes/dce-g5-proyecto_integrador/python/Buck/graficos/Recta_de_Carga.png

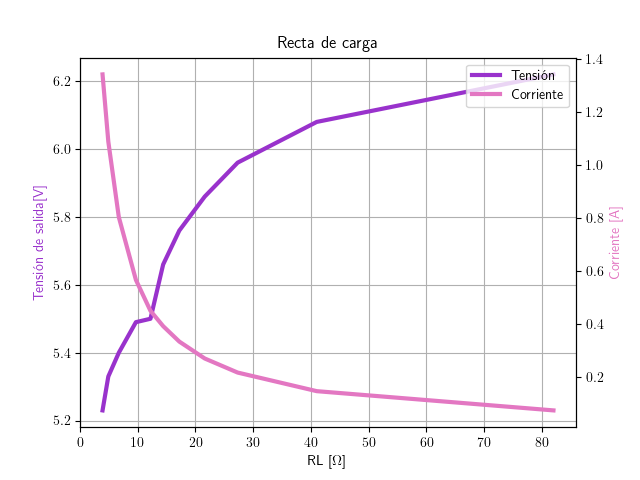
python/Buck/graficos/Recta_de_Carga.png
