DeniseViltes/dce-g5-proyecto_integrador/python/Buck/graficos/salidas_buck.png

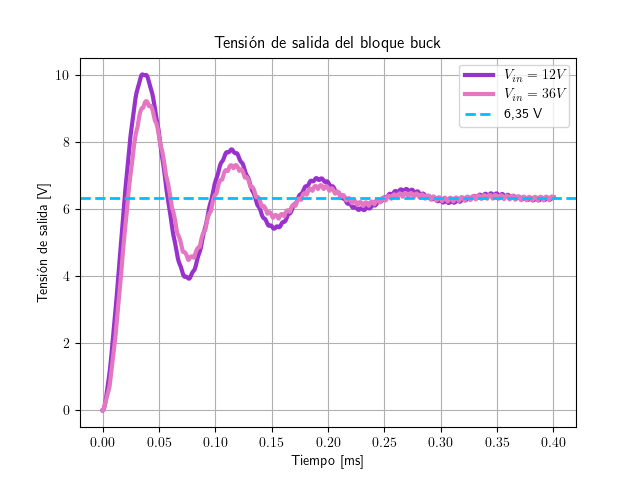
python/Buck/graficos/salidas_buck.png
