DeniseViltes/dce-g5-proyecto_integrador/python/Buck/graficos/salidas_buck_zoom.png

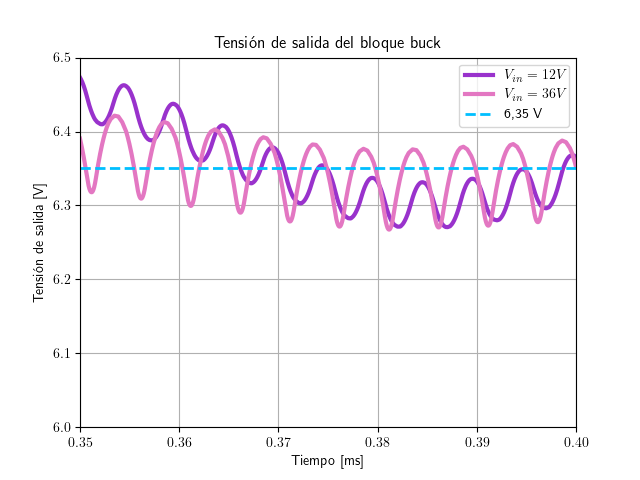
python/Buck/graficos/salidas_buck_zoom.png
