DeniseViltes/dce-g5-proyecto_integrador/python/Buck/graficos/support.png

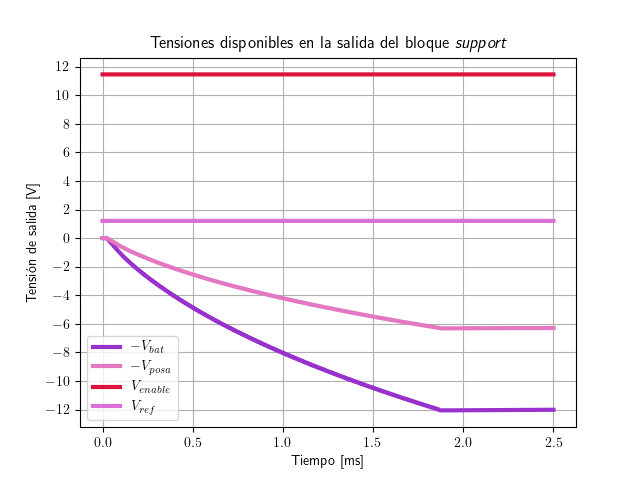
python/Buck/graficos/support.png
