DeniseViltes/dce-g5-proyecto_integrador/python/Buck/graficos/TransferenciaCompensada.png

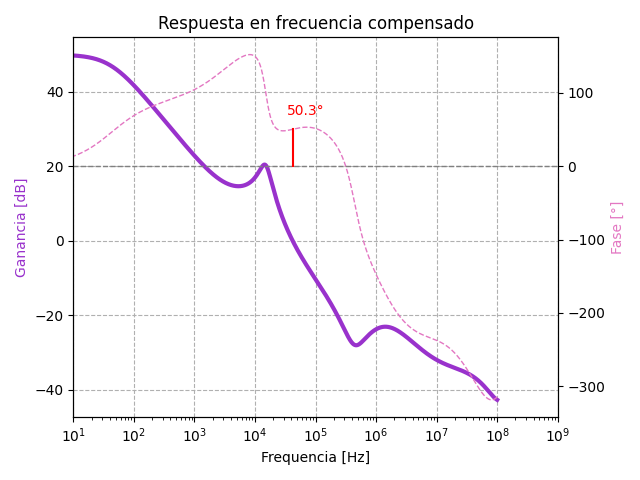
python/Buck/graficos/TransferenciaCompensada.png
