DeniseViltes/dce-g5-proyecto_integrador/python/Buck/graficos/TransferenciaSinCompensar.png

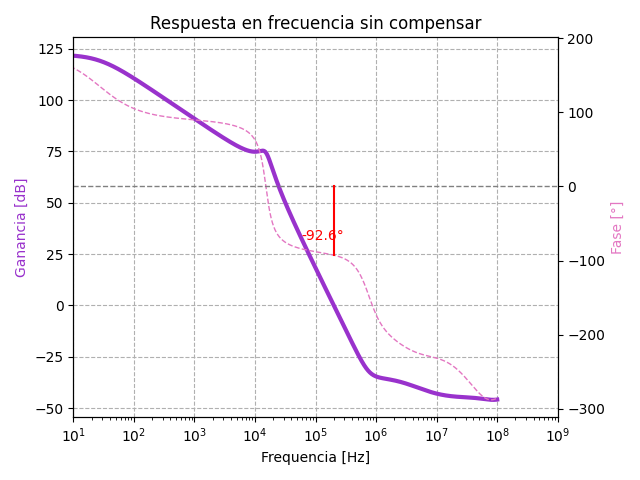
python/Buck/graficos/TransferenciaSinCompensar.png
