DeniseViltes/dce-g5-proyecto_integrador/python/Buck/graficos/Transitorios.png

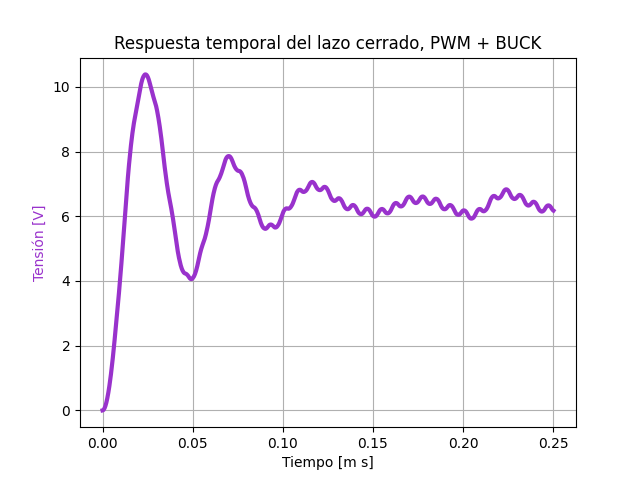
python/Buck/graficos/Transitorios.png
