DeniseViltes/dce-g5-proyecto_integrador/python/Buck/graficos/TransitoriosGananciaTension-Vin_12.png

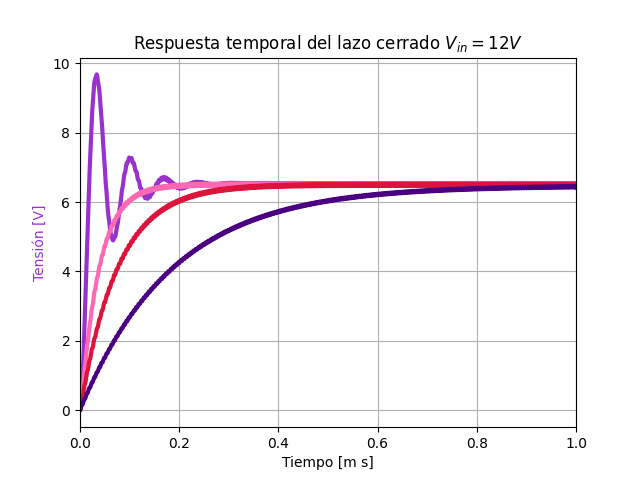
python/Buck/graficos/TransitoriosGananciaTension-Vin_12.png
