DeniseViltes/dce-g5-proyecto_integrador/python/Buck/resources/rtaFreqInductor.png

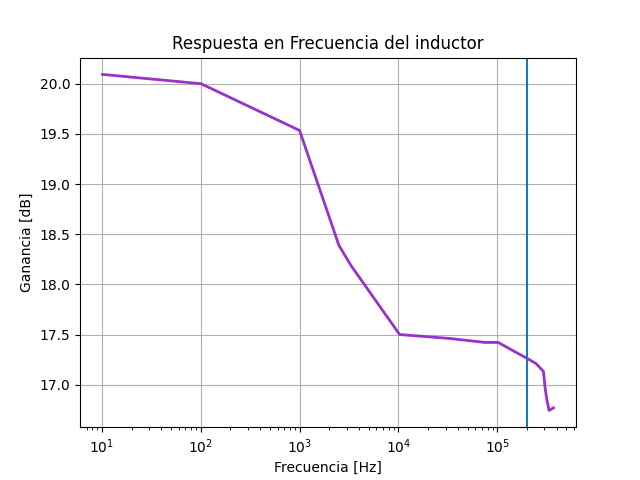
python/Buck/resources/rtaFreqInductor.png
