DeniseViltes/dce-g5-proyecto_integrador/python/graficos/Foldback.png

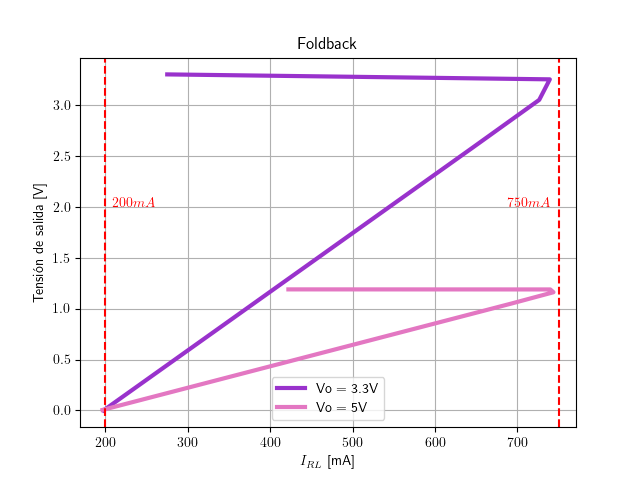
python/graficos/Foldback.png
