DeniseViltes/dce-g5-proyecto_integrador/python/graficos/FoldbacksCompensados.png

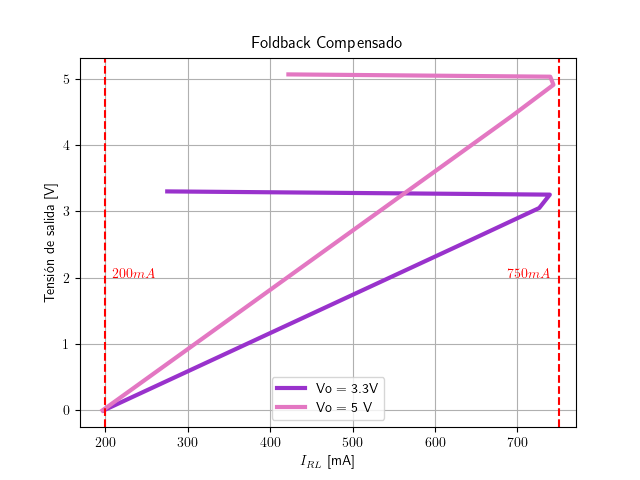
python/graficos/FoldbacksCompensados.png
