DeniseViltes/dce-g5-proyecto_integrador/python/graficos/Ganancia de lazo.png

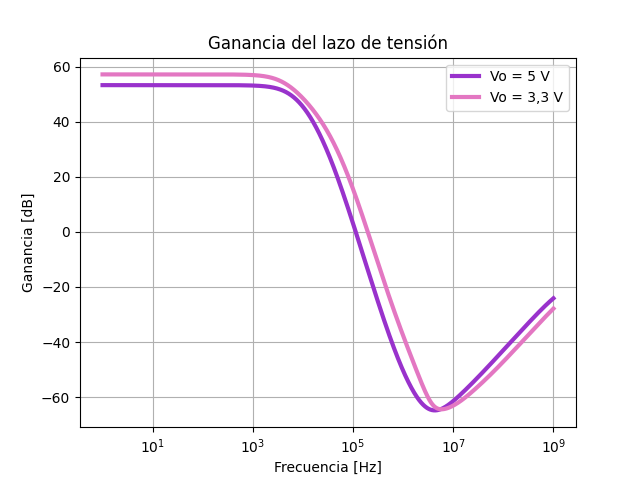
python/graficos/Ganancia de lazo.png
