DeniseViltes/dce-g5-proyecto_integrador/python/graficos/potencia.png

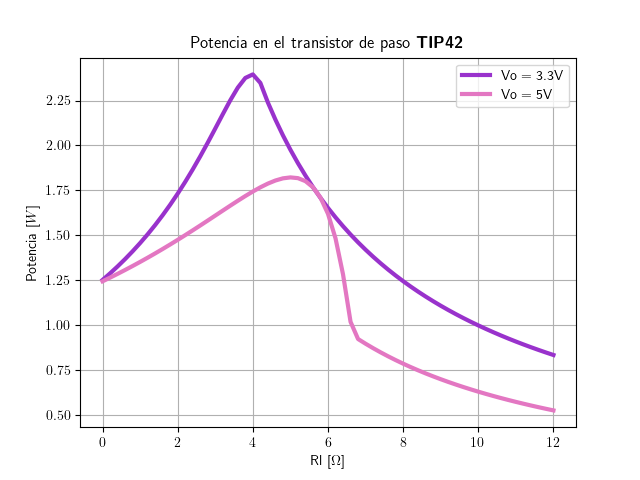
python/graficos/potencia.png
