DeniseViltes/dce-g5-proyecto_integrador/python/graficos/rectasDeCarga.png

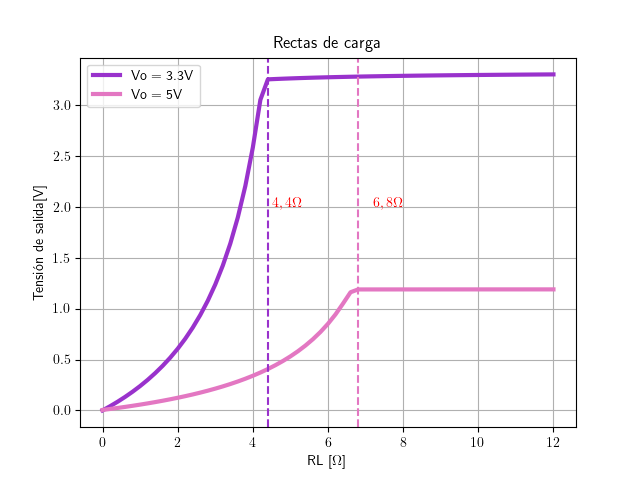
python/graficos/rectasDeCarga.png
