DeniseViltes/dce-g5-proyecto_integrador/python/graficos/rectasDeLinea.png

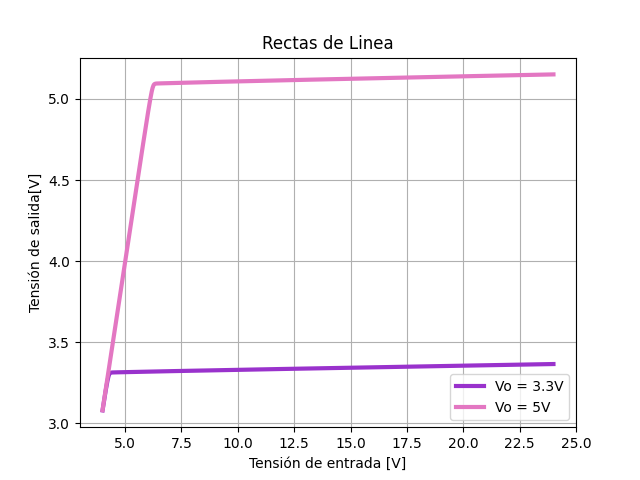
python/graficos/rectasDeLinea.png
