DeniseViltes/dce-g5-proyecto_integrador/python/graficos/TransferenciaLazoCorrienteCompensado3.png

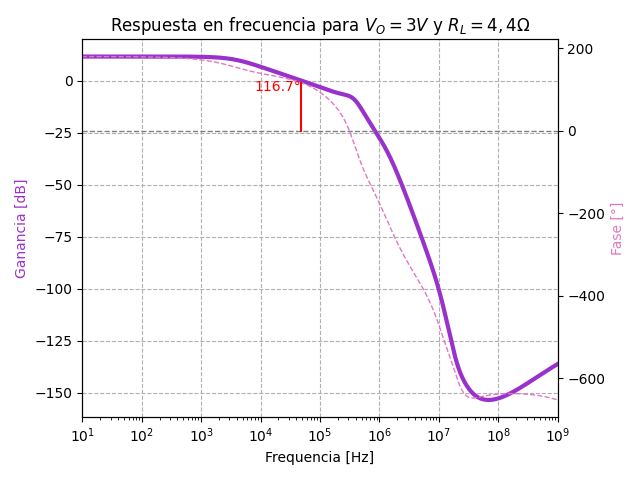
python/graficos/TransferenciaLazoCorrienteCompensado3.png
