DeniseViltes/dce-g5-proyecto_integrador/python/graficos/TransferenciaLazoCorrienteSinCompensar3_RL-6.png

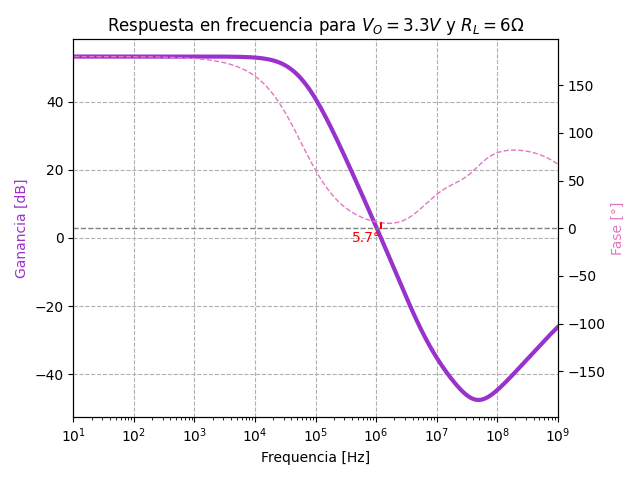
python/graficos/TransferenciaLazoCorrienteSinCompensar3_RL-6.png
