DeniseViltes/dce-g5-proyecto_integrador/python/graficos/TransferenciaLazoCorrienteSinCompensar5_RL-68.png

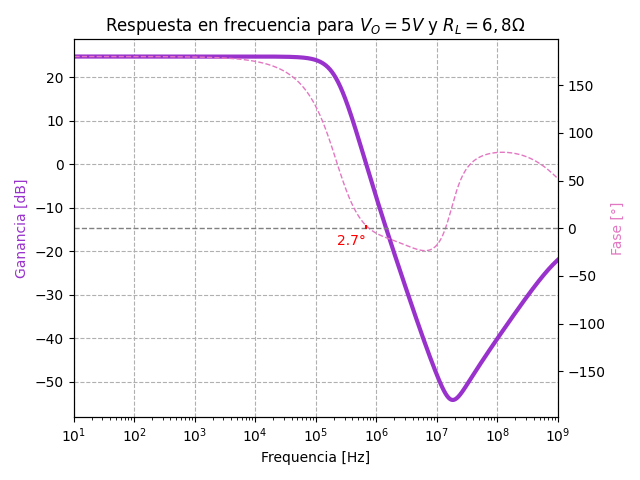
python/graficos/TransferenciaLazoCorrienteSinCompensar5_RL-68.png
