DeniseViltes/dce-g5-proyecto_integrador/python/graficos/TransferenciaLazoTensionCompensado3_RL-10.png

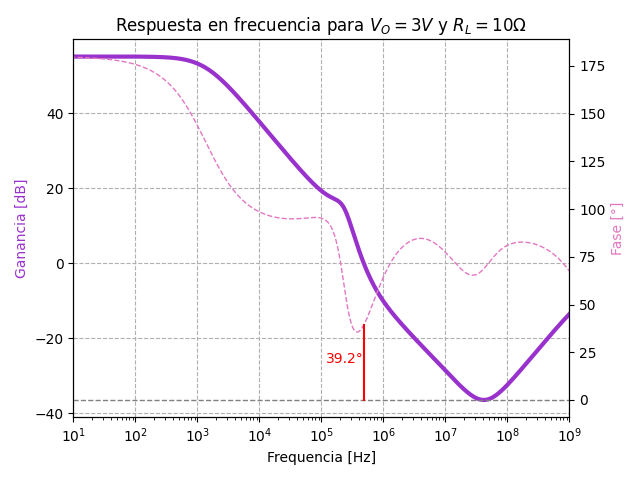
python/graficos/TransferenciaLazoTensionCompensado3_RL-10.png
