DeniseViltes/dce-g5-proyecto_integrador/python/graficos/TransferenciaLazoTensionCompensado5_RL-10.png

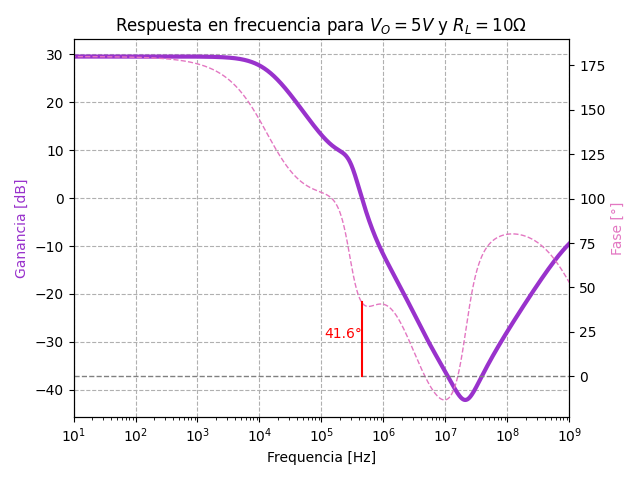
python/graficos/TransferenciaLazoTensionCompensado5_RL-10.png
