DeniseViltes/dce-g5-proyecto_integrador/python/graficos/TransitorioFoldaback3.png

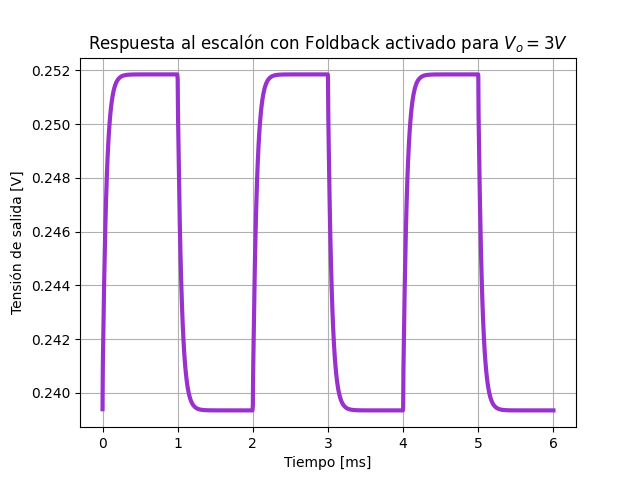
python/graficos/TransitorioFoldaback3.png
