DeniseViltes/dce-g5-proyecto_integrador/python/graficos/TransitoriosGananciaCorriente.png

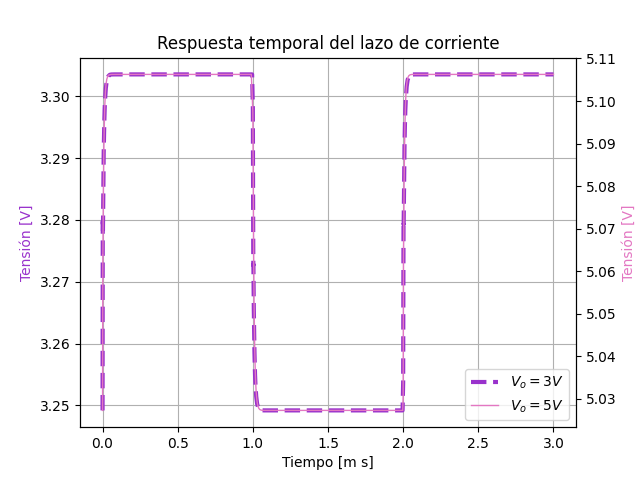
python/graficos/TransitoriosGananciaCorriente.png
