DeniseViltes/dce-g5-proyecto_integrador/python/graficos/TransitoriosGananciaTension.png

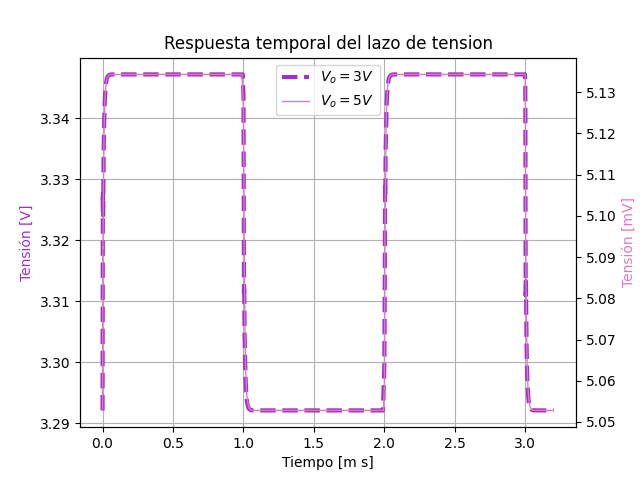
python/graficos/TransitoriosGananciaTension.png
