DeniseViltes/dce-g5-proyecto_integrador/Checkpoint 4/ResultadoCuentitas.txt

Duty: 0.5291666666666667
T: 5e-06
ton: 2.6458333333333336e-06
Is (minimo): 0.02
delta Il: 0.02
L (critico): 0.0003737239583333334
R (critico): 317.5
C: 1.25e-07
tau: 3.9687499999999996e-05
cumple: No
Duty: 0.17638888888888887
T: 5e-06
ton: 8.819444444444444e-07
Is (minimo): 0.02
delta Il: 0.02
L (critico): 0.0006537413194444444
R (critico): 317.5
C: 1.25e-07
tau: 3.9687499999999996e-05
cumple: No
