DeniseViltes/dce-g5-proyecto_integrador/Checkpoint 2/DCE - PCB - v1/print.pdf

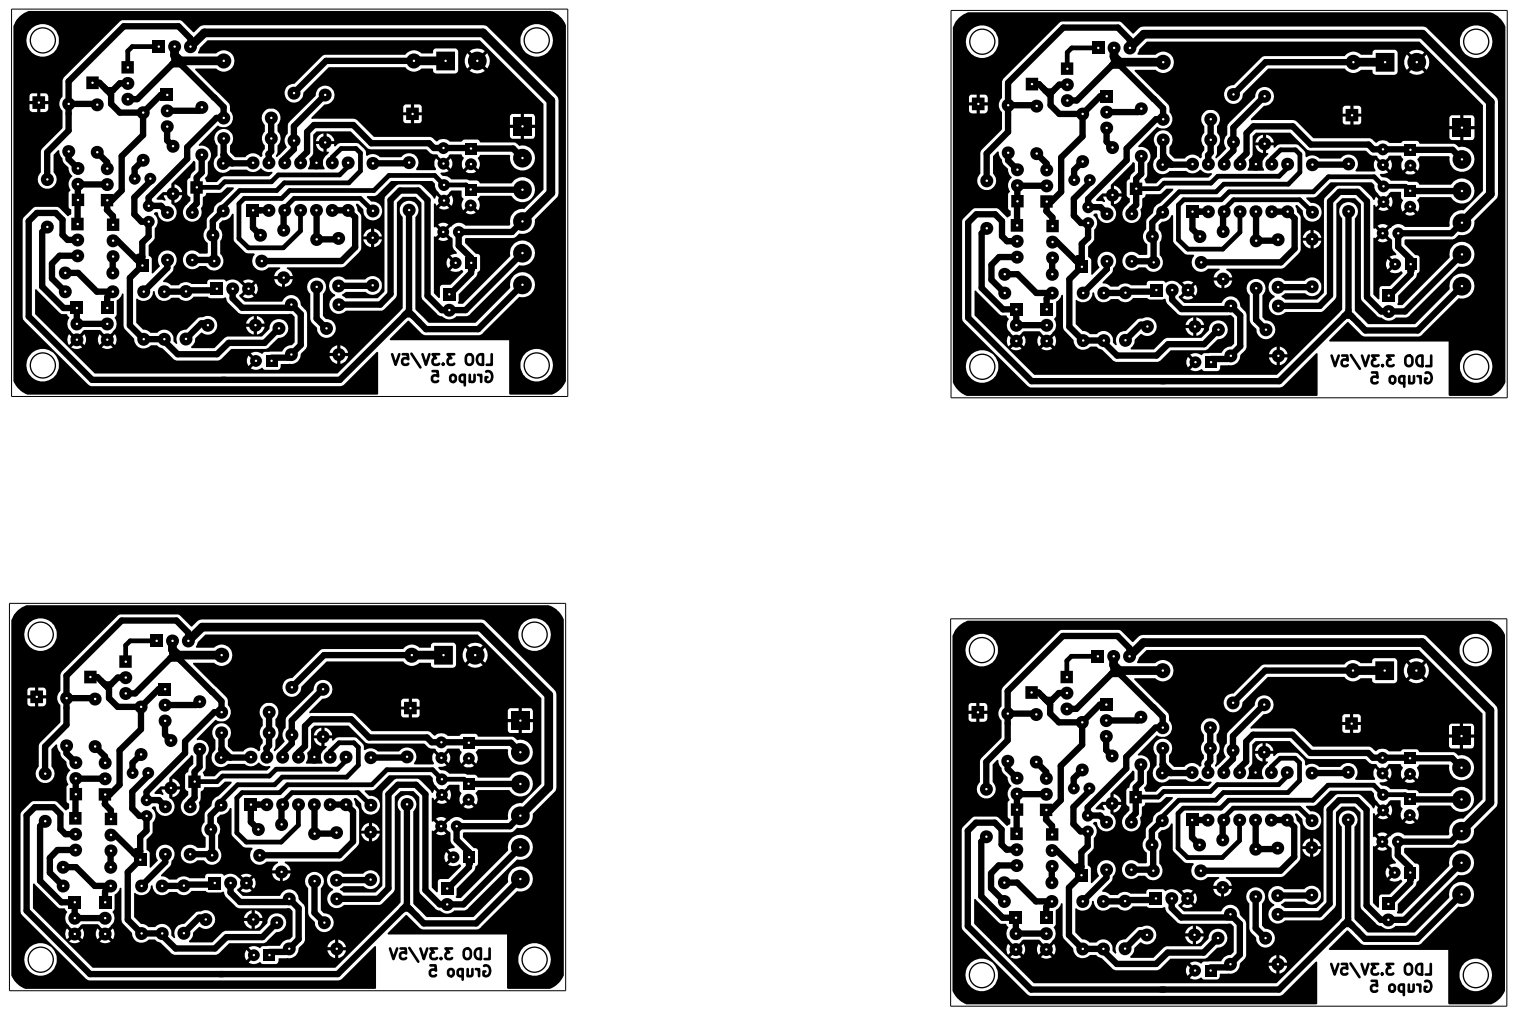
[picture p76: page 1]
