DeniseViltes/dce-g5-proyecto_integrador/Checkpoint 4/Buck/pcb_buck/pcb_buck-B_Cu.pdf

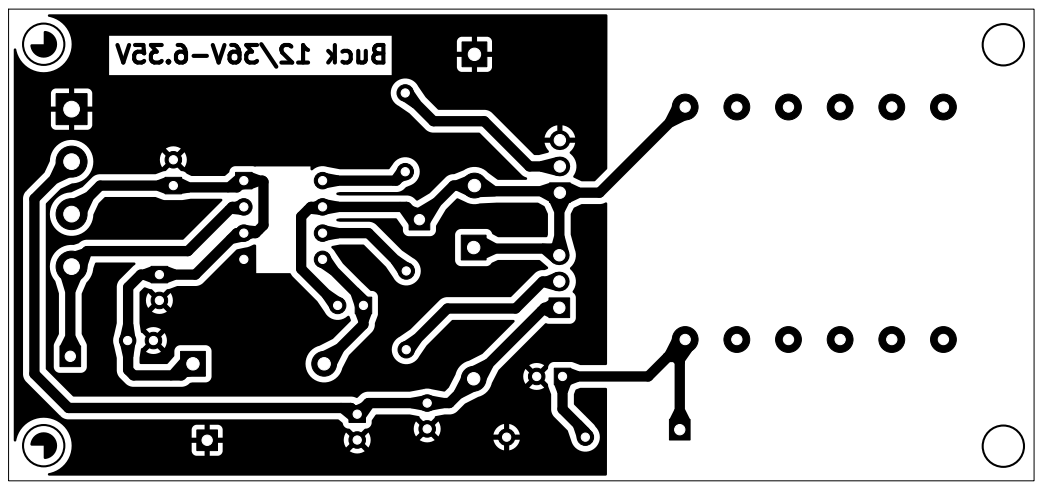
[picture p77: page 1]
