DeniseViltes/dce-g5-proyecto_integrador/Checkpoint 4/PWM/pcb_pwm/pcb_pwm-B_Cu.pdf

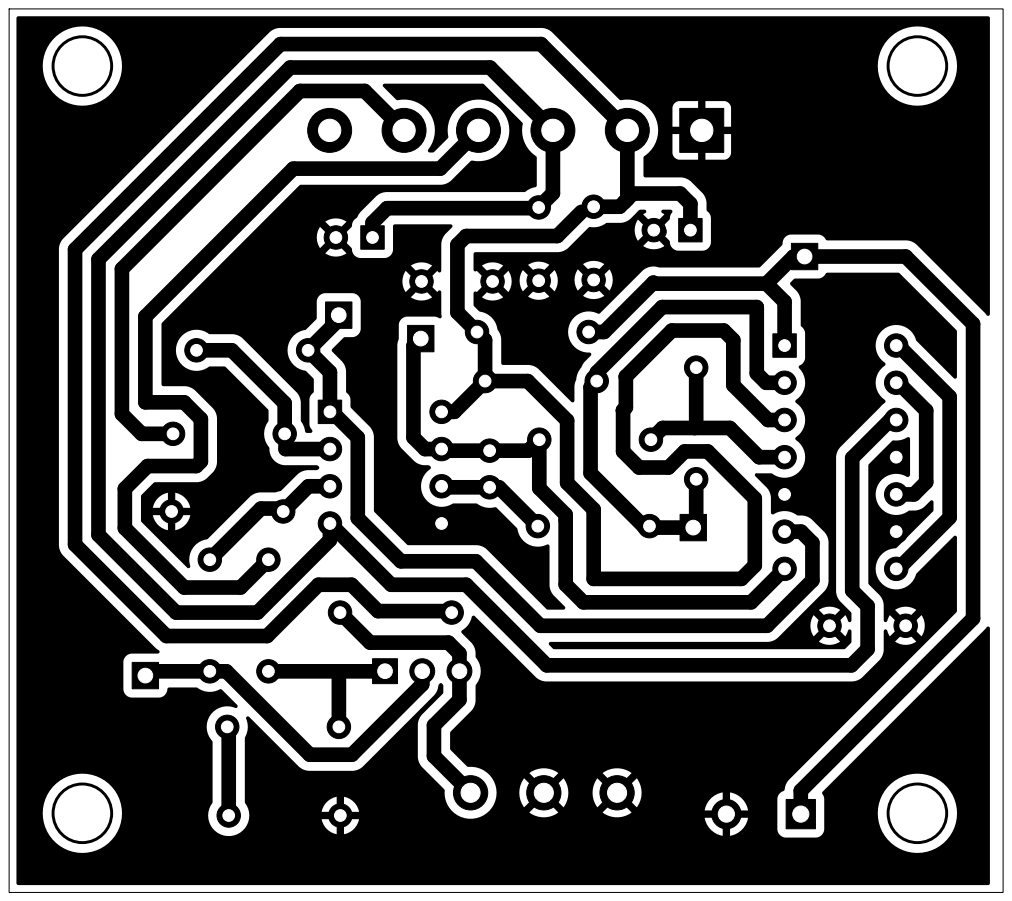
[picture p78: page 1]
