DeniseViltes/dce-g5-proyecto_integrador/Checkpoint 4/PWM/pcb_pwm/gdf.pdf

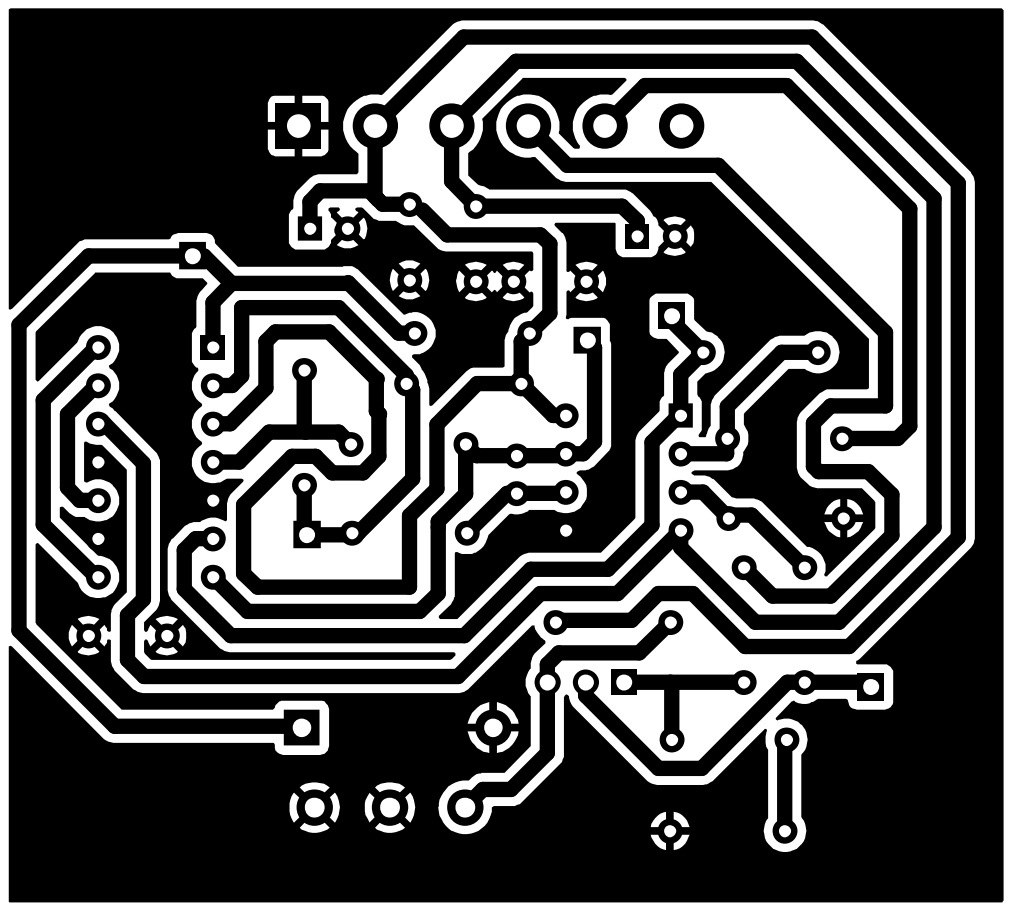
[picture p79: page 1]
