DeniseViltes/dce-g5-proyecto_integrador/Checkpoint 2/Simulación.asc

C1: cap; 2.2n
C2: cap; 1Meg
C4: cap; 100p
C5: cap; {Cdes}
C6: cap; {Cdes}
C7: cap; {Cdes}
C8: cap; {Cdes}
C9: cap; {Cdes}
CL: cap; {CL}
Cp: cap; 1Meg
L1: ind; 1Meg
Lp: ind; 1Meg
M1: nmos; 2N7002
Pulso: voltage; PULSE(-10m 10m 0 1f 1f 1m 2m)
Q1: pnp; BC557B
Q2: pnp; BC557B
Q3: npn; BC547B
Q4: npn; BC547B
Q5: npn; BC547B
Q6: npn; BC547B
Q7: npn; BC547B
Q8: npn; BC547B
Q9: pnp; TIP42C
R1: res; 2.7k
R2: res; 390
R3: res; 1K
R4: res; 680
R5: res; 270
R6: res; 3.3k
R7: res; 2.7k
R8: res; 510
R9: res; 10k
R10: res; 10k
R11: res; 1.2k
R12: res; 220
R14: res; 100k
R15: res; 1k
R16: res; 1.5k
R18: res; 1.5k
R19: res; 1.5k
R20: res; 6.8k
R21: res; 6.8k
R22: res; 1.5k
R23: res; 5.6k
R25: res; 100
R26: res; 1k
R27: res; 1k
RE1: res; 470
RE2: res; 470
RL: res; {RL}
Rs: res; 0.1
SELA1: voltage; {SELA}
U1A: opamp2; LM324
U1B: opamp2; LM324
U2A: opamp2; LM324
U2B: opamp2; LM324
V1: voltage; {VREFDC}; AC {VREFAC}
V2: voltage; ""; AC 1
Vp: voltage; ""; AC 1
VPOSA1: voltage; 5
VPOSA2: voltage; -5
Vreg1: voltage; {VINDC}; AC {VINAC}
Named nets: Vf, 0, +VPOSA, Vref, Sum, Vlc, Vreg, SELA, Vo, -VPOSA
.op
.param VINDC 6.35
.param VINAC 1
.param VREFDC=1.2
.param VREFAC 0
.param RL=10
.dc Vreg1 4 24
.step param RL 1u 12 0.2
.MODEL TIP42C PNP(Is=66.19f Xti=3 Eg=1.11 Vaf=100 Bf=137.6 Ise=862.2f Ne=1.481 Ikf=1.642 Nk=.5695 Xtb=2 Br=5.88 Isc=273.5f Nc=1.24 Ikr=3.555 Rc=79.39m Cjc=870.4p Mjc=.6481 Vjc=.75 Fc=.5 Cje=390.1p Mje=.4343 Vje=.75 Tr=235.4n Tf=23.21n Itf=71.33 Xtf=5.982 Vtf=10 Rb=.1 Vceo=100 Icrating=6 mfg=Texas)
.MODEL TIP41C NPN (IS=7.55826e-11 BF=260.542 NF=1.11221 VAF=100 IKF=0.526814 ISE=1e-08 NE=2.18072 BR=26.0542 NR=1.5 VAR=1000 IKR=3.54059 ISC=1e-08 NC=1.63849 RB=4.56157 IRB=0.1 RBM=0.1 RE=0.0162111 RC=0.0810556 XTB=0.1 XTI=1 EG=1.206 CJE=1.93296e-10 VJE=0.4 MJE=0.259503 TF=1e-08 XTF=4.06972 VTF=7.1157 ITF=0.001 CJC=1.09657e-10 VJC=0.730921 MJC=0.23 XCJC=0.803085 FC=0.8 TR=9.01013e-08 PTF=0 Vceo=100 ICrating=6 mfg=ON_Semi)
.inc LM324.lib
.tran 0.99999
R = 100*(1-TIME)
.param SELA=0
.ac dec 1000 1 1G
.step param RL list 1 10
.step param SELA list 0 5
.tran 0 6m 0 0.01m
.step param CL list 1u 2.2u 15u
.param CL 2.2u
.param Cdes 10u
.step param RL 4.5 10 5
