DeniseViltes/dce-g5-proyecto_integrador/Checkpoint 4/Buck/Buck-lazo-abierto.asc

C1: cap; 150n
C2: cap; 0.33µ
C3: cap; 1µ
D1: schottky; D1n5822rl
D2: schottky; D1n5822rl
D3: schottky; D1n5822rl
IL: ind; 738µ
M1: nmos; IRFZ44N
M2: nmos; IRFZ44N
R1: res; 330
R2: res; 10
R3: res; 10
R4: res; {Rload}
U1: IR2104
V1: voltage; {Vin}; AC 1 0
V2: voltage; PULSE(0 12 0 1n 1n {ton} {T})
V3: voltage; 12; AC 1 0
Named nets: 0, Vo, Vd, pwm, vdd, vcc
.lib IR2104.lib
.lib 1N5822RL.LIB
.option noopiter
.option gmin=1e-9
.param TiempoMuerto 310n
Dutys: {0.52916, 0.17638888}
.param Duty (6.35/Vin)
.param fsw  200k
.param ton (Duty/fsw)
.param Vin 12
.param T (1/fsw)
.param Duty (6.35/Vin * (1+TiempoMuerto/T))
.tran 0 400u 0 uic
.option cshunt 1e-30
.option abstol 10p
.lib sihf540.lib
.op
.step param Rload 100 4 4
