DeniseViltes/dce-g5-proyecto_integrador/Checkpoint 5/Buck-compensado/buck_average_CL.asc

B1: bv; V=limit(v(ctrl), 0.01, 0.9)
C1: cap; 150n
C3: cap; 2.2n
C4: cap; 22n
L1: ind; 738µ
R1: res; 2k2
R2: res; 220
R3: res; 2k2
R4: res; 207
R5: res; 100
Rload1: res; {RLOAD}
U1: ccm1; CCM2; Ron=8m
U2: LT1215
Vg1: voltage; 12; AC 1
Vg2: voltage; {VIN}; AC 1
Vref1: voltage; PULSE(0 10 0 1n 1n {ton} {T}); AC 0
Vz1: voltage; ""; AC 1
Named nets: 0, VPOS, ctrl, x, y, out, d, in, vd
Simulation directives
.lib average.lib
.ac dec 1000 1 100Meg
.step param RLOAD list 4 10 20 330
;dc Vduty 0.2 0.9 0.01
.tran 0 5m 0 1u
.param RLOAD 330
.param Duty (6.35/Vin)*0.7
.param fsw  200k
.param ton (Duty/fsw)
.param Vin 36
.param T (1/fsw)
Dutys: {0.52916, 0.17638888}
