DeniseViltes/dce-g5-proyecto_integrador/Checkpoint 5/Buck-compensado/buck_average_CL_noCompensado.asc

B1: bv; V=limit(v(ctrl), 0.01, 0.9)
C1: cap; 150n
C2: cap; 1Meg
L1: ind; 738µ
L2: ind; 1Meg
R4: res; 207
R5: res; 100
Rload: res; {RLOAD}
U1: ccm1; CCM2; Ron=8m
U2: LT1215
V1: voltage; ""; AC 1
Vg1: voltage; 12; AC 1
Vg: voltage; {VIN}; AC 0
Vref1: voltage; PULSE(0 10 0 1n 1n {ton} {T}); AC 0
Vz1: voltage; ""; AC 1
Named nets: 0, out, d, in, VPOS, ctrl, x, y, vd
Simulation directives
.lib average.lib
.ac dec 1000 1 100Meg
.step param RLOAD list 4 10 20 330
.dc Vduty 0.2 0.9 0.01
.tran 0 1m 0 1u
.param RLOAD 330
.param TiempoMuerto 310n
.param Duty (6.35/Vin)
.param fsw  200k
.param ton (Duty/fsw)
.param Vin 12
.param T (1/fsw)
.param Duty (6.35/Vin * (1+TiempoMuerto/T))
Dutys: {0.52916, 0.17638888}
