DeniseViltes/dce-g5-proyecto_integrador/Checkpoint 5/Buck_lazo_cerrado/Buck-lazo-cerrado.asc

C1: cap; 150n
C2: cap; 0.33µ
C3: cap; 1µ
C4: cap; 220p
D1: schottky; D1n5822rl
D2: schottky; D1n5822rl
D3: schottky; D1n5822rl
D4: diode; Dmur1560
IL: ind; 700µ
M1: nmos; IRFZ44N
M2: nmos; IRFZ44N
R1: res; 330
R2: res; 10
R3: res; 10
R4: res; 120
R5: res; 3k3
R6: res; 180k
R7: res; 18k
R8: res; 39k
R9: res; 390k
R10: res; 390k
R11: res; 390k
R12: res; 2.5k
R13: res; 390k
R14: res; 8.2k
R16: res; 78
R29: res; 1k
R30: res; 207
R31: res; 100
U2: TL081
U3: TL081
U4: opamp2; LM2901
U6: LTC6702
U9: IR2104
U12: opamp2; LM2901
V1: voltage; 12
V2: voltage; 12
V3: voltage; SINE(6.35 0.1 200k)
V4: voltage; 2.5
V5: voltage; {vcc}
V6: voltage; {vcc}
V7: voltage; {vcc}
V8: voltage; {vcc}
V9: voltage; {vcc}
V10: voltage; {vcc}
Named nets: 0, Vd, vdd, VCC3, pwm, VCC, -VCC, VCC2, -VCC2, Vref, Vcomp, -VCC3
.lib IR2104.lib
.lib 1N5822RL.LIB
.option noopiter
.option gmin=1e-9
.lib MUR1560.REV0.LIB
.param vcc 12
.lib lm2901.lib
.lib TL081.lib
Banco de Suplentes
.tran 250u
.option cshunt 1e-30
.option abstol 10p
Tomemos con pinzas lo de las .options
Son para que anden más rápido las simulacioens
.param R_var=207
;step param R_var list  51 100 220
