DeniseViltes/dce-g5-proyecto_integrador/Checkpoint 4/PWM/Ejemplo de modulador triangular en LTSPICE.asc

C1: cap; 100p
D1: diode; Dmur1560
R5: res; 39k
R6: res; 220k
R7: res; 5k
R13: res; 120
R14: res; 78
R15: res; 100k
R16: res; 100k
R17: res; 100k
R18: res; 100k
R19: res; 8.2k
R20: res; 2k
R21: res; 10k
R22: res; 500
U1: TL081
U4: TL081
U7: opamp2; LM2901
U8: opamp2; LM2901
V1: voltage; 12
V2: voltage; SINE(6.35 0.1 200k)
V3: voltage; 2.5
V4: voltage; 12
V9: voltage; 12
V10: voltage; 12
V11: voltage; 12
Named nets: VCC, Va, Vb, 0, Vr, -VCC, Vref, VCC2, -VCC2, Vo
.tran 0 30u 14u uic
.model IRF9540 PMOS(Level=3 Gamma=0 Delta=0 Eta=0 Theta=0 Kappa=0.2 Vmax=0 Xj=0
+ Tox=100n Uo=300 Phi=.6 Rs=64.15m Kp=10.18u W=1.5 L=2u
+ Vto=-3.646 Rd=62.45m Rds=444.4K Cbd=2.029n Pb=.8 Mj=.5 Fc=.5
+ Cgso=1.033n Cgdo=469.4p Rg=.3371 Is=54.08E-18 N=2 Tt=140n)
.model 1N4002 D (Is=14.11n N=1.984 Rs=33.89E-3 Ikf=94.81 Xti=3 Eg=1.110 Cjo=51.17E-12)
.lib lm2901.lib
R4 Aumentarla
Aumenta la ampl de la triang
Dismin la frec
R3 Aumentarla
Disminuye la ampl de la triang
Aumenta la frec
C1 Aumentarla
 Aumenta la ampl de la triang
Disminuye la frec
.lib MUR1560.REV0.LIB
