DeniseViltes/dce-g5-proyecto_integrador/Checkpoint 5/Buck_lazo_cerrado/Buck-lazo-cerrado2.asc

C1: cap; 150n
C2: cap; 0.33µ
C3: cap; 1µ
C4: cap; 100p
D1: schottky; D1n5822rl
D2: schottky; D1n5822rl
D3: schottky; D1n5822rl
D4: zener
IL: ind; 700µ
IR2104: DIP8; IR2104
R1: res; 330
R2: res; 10
R3: res; 10
R4: res; 120
R5: res; 5k
R6: res; 220k
R7: res; 5.1k
R8: res; 39k
R9: res; 100k
R10: res; 100k
R11: res; 100k
R12: res; 2.5k
R13: res; 100k
R14: res; 8.2k
R15: res; 60
R16: res; 78
R28: res; 100
R29: res; 10k
R30: res; {R_var}
R31: res; 100
U1: irlz44zsl
U2: TL081
U3: TL081
U4: opamp2; LM2901
U5: irlz44zsl
U6: LTC6702
U11: irlz44zsl
U12: opamp2; LM2901
U13: IR2104
V1: voltage; 12
V2: voltage; 12
V3: voltage; SINE(6.35 0.1 200k)
V4: voltage; 2.5
V5: voltage; {vcc}
V6: voltage; {vcc}
V7: voltage; {vcc}
V8: voltage; {vcc}
V9: voltage; {vcc}
V10: voltage; {vcc}
Named nets: 0, Vd, vdd, VCC3, pwm, VCC, -VCC, VCC2, -VCC2, Vref, Vcomp, -VCC3
.lib IR2104.lib
.lib 1N5822RL.LIB
.option noopiter
.option gmin=1e-9
.lib irlz44zsl.spi
.param vcc 12
.lib lm2901.lib
.lib TL081.lib
Banco de Suplentes
.tran 0 250u 0 5u
.option cshunt 1e-30
.option abstol 10p
Tomemos con pinzas lo de las .options
Son para que anden más rápido las simulacioens
.param R_var=207
;step param R_var list  51 100 220
