DeniseViltes/dce-g5-proyecto_integrador/Checkpoint 4/Support/Support4.asc

BAT: voltage; 12
Buck: voltage; 6.35
C1: cap; 100µ
C2: cap; 1.5n
C3: cap; 100µ
D1: schottky; RBQ20T45ANZ
L1: ind; 90µ
R1: res; 0.22
R2: res; 8.2k
R3: res; 953
R4: res; 1k
R5: res; 1.1k
R11: res; 10k
R12: res; 11.24k
RA: res; 10
RB: res; 100k
Ro1: res; 1.5k
Ro2: res; 1.4k
Rs: res; 1k
U1: MC33063A-Q1_TRANS
U2: tl431
U6: TLV3201
Named nets: 0, Vref, Vbat, Vbuck, Venable, -VPOSA, -Vbat
.tran 0 2.5m 0 1u
Vref = 1,2V
Venable = 12V
-VPOSA = -6.35V
-Vbat = -12V
.inc tl431.lib
.inc tlv3201.lib
.inc MC33063A_2.lib
