DeniseViltes/dce-g5-proyecto_integrador/Checkpoint 4/PWM/PWM.asc

C1: cap; 100p
R2: res; 10k
R3: res; 200k
R4: res; 27k
R5: res; 66k
R6: res; 1k
R7: res; 68
R8: res; 10k
R10: res; 100k
R11: res; 100k
R12: res; 100k
R13: res; 100k
R14: res; 120
R15: res; 10
R16: res; 8.2k
U1: TL081
U4: LTC6702
U5: LTC6702
U7: TL081
V1: voltage; 12
V2: voltage; SINE(6.35 0.1 200k)
V3: voltage; 2.5
V4: voltage; 12
V5: voltage; 12
Named nets: VCC, Va, Vb, 0, Vr, Vo, -VCC, Vref
.tran 0 30u 14u uic
.model IRF9540 PMOS(Level=3 Gamma=0 Delta=0 Eta=0 Theta=0 Kappa=0.2 Vmax=0 Xj=0
+ Tox=100n Uo=300 Phi=.6 Rs=64.15m Kp=10.18u W=1.5 L=2u
+ Vto=-3.646 Rd=62.45m Rds=444.4K Cbd=2.029n Pb=.8 Mj=.5 Fc=.5
+ Cgso=1.033n Cgdo=469.4p Rg=.3371 Is=54.08E-18 N=2 Tt=140n)
.model 1N4002 D (Is=14.11n N=1.984 Rs=33.89E-3 Ikf=94.81 Xti=3 Eg=1.110 Cjo=51.17E-12)
.inc LM324.lib
R4 Aumentarla
Aumenta la ampl de la triang
Dismin la frec
R3 Aumentarla
Disminuye la ampl de la triang
Aumenta la frec
C1 Aumentarla
 Aumenta la ampl de la triang
Disminuye la frec
.lib LM393.lib
