DeniseViltes/dce-g5-proyecto_integrador/Checkpoint 4/Support/Support3.asc

BAT: voltage; 12
Buck: voltage; 6.35
C1: cap; 100µ
C2: cap; 1.5n
C3: cap; 100µ
D1: zener; MMBZ6V8ALY
L1: ind; 90µ
R1: res; 0.22
R2: res; 8.2k
R3: res; 953
R4: res; 10k
R5: res; 50
R6: res; 1k
R7: res; 1k
R8: res; 1k
R11: res; 10k
R12: res; 11.24k
RA: res; 10
RB: res; 100k
Ro1: res; 1k
Ro2: res; 120
Ro3: res; 820
Rs: res; 1k
U1: tl431
U4: UniversalOpAmp4
U6: TLV3201
U7: MC33063A-Q1_TRANS
V1: voltage; 6.35
V2: voltage; 10
V3: voltage; 10
Named nets: 0, Vref, Vbat, Vbuck, Venable, -VPOSA, alim, nalim
.tran 0 1.5m 0 1u
.inc TL431.lib
Vref = 1,2V
Venable = 12V
