DeniseViltes/dce-g5-proyecto_integrador/Checkpoint 4/PWM/Actividad de PWM.asc

C1: cap; 0.047µ
C2: cap; 10µ
C3: cap; 0.1µ
C3a: cap; 0.1µ
C4: cap; 10µ
D1: diode; 1N4004
D2: diode; 1N4004
R1: res; 1k8
R2: res; 22k
R3: res; 10k
R4: res; 47k
R5: res; 47k
R6: res; 3k9
R7: res; 1k8
R8: res; 100k
R9: res; 100
R10: res; 390
R11: res; 390k
R12: res; 0.003
R13: res; 1k
R14: res; 39
RL: res; 1
U1: RFP50N06-HARRIS
U2: opamp2; LM324
U3: opamp2; LM324
U4: opamp2; LM324
U5: opamp2; LM324
Vbatt: voltage; 12V
VR1a: res; {10k*(1-{k2})}
VR1b: res; {10k*{k2}}
VR2a: res; {20k*(1-{k1})}
VR2b: res; {20k*{k1}}
VR3a: res; {1k*(1-{k3})}
VR3b: res; {1k*{k3}}
Z1: zener; 1N5348B
Named nets: 0, Va, V2, V3, Vo, V1
.MODEL 1N5348B D(IS=1.91E-15 RS=2.29 TT=5.01E-8 CJO=4.47E-10 M=0.33 
+ BV=10.71 IBV=0.125 )
.MODEL 1N4004 D(IS=2.55E-9 RS=0.042 N=1.75 TT=5.76E-6 CJO=1.85E-11 
+ VJ=0.75 M=0.333 BV=400 IBV=3.95E-5 )
.tran 0 4m 0
.param k1=0.5 k2=0.5 k3=0.5
.inc LM324.lib
