DeniseViltes/dce-g5-proyecto_integrador/Checkpoint 4/Support/pcb_support/pcb_support.kicad_pcb

## KiCad design Checkpoint 4/Support/pcb_support/pcb_support.kicad_pcb (2024-12-05)

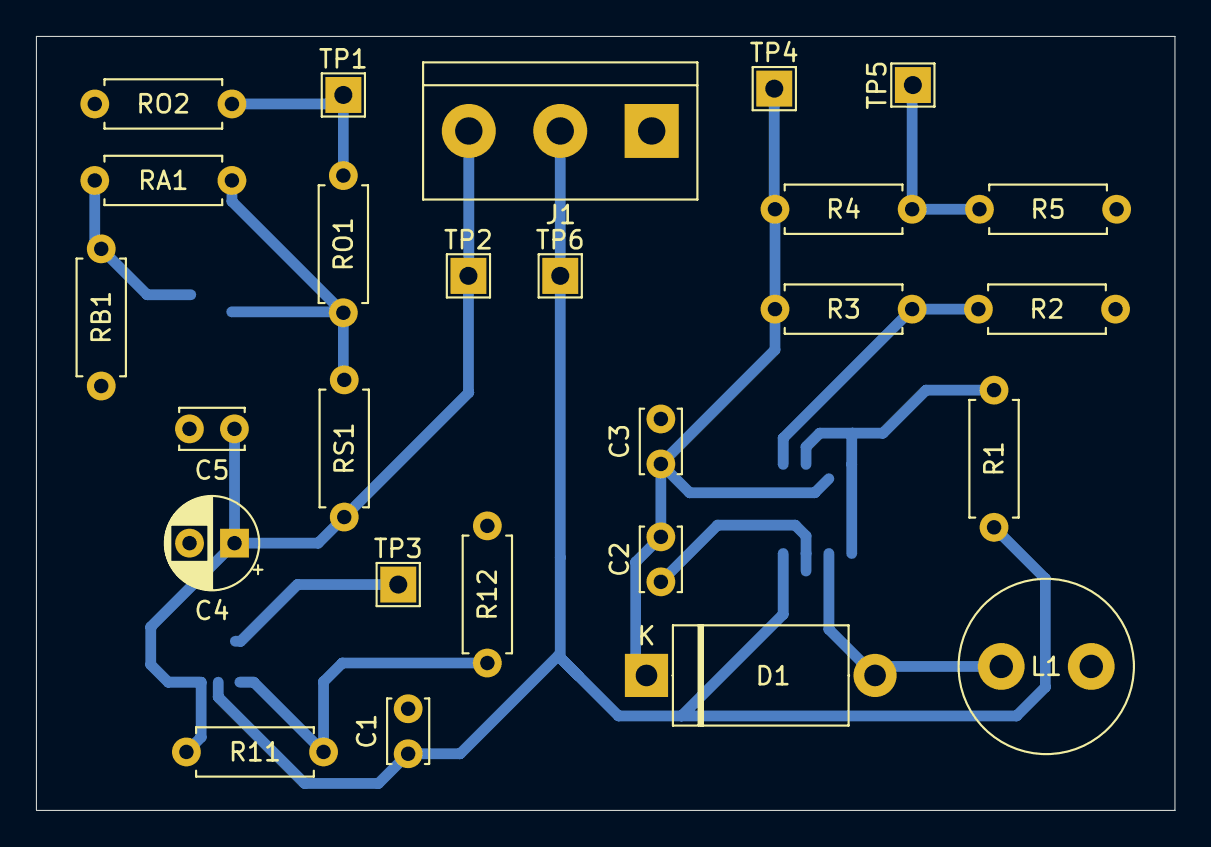
[picture p80: board pcb_support.kicad_pcb from above]

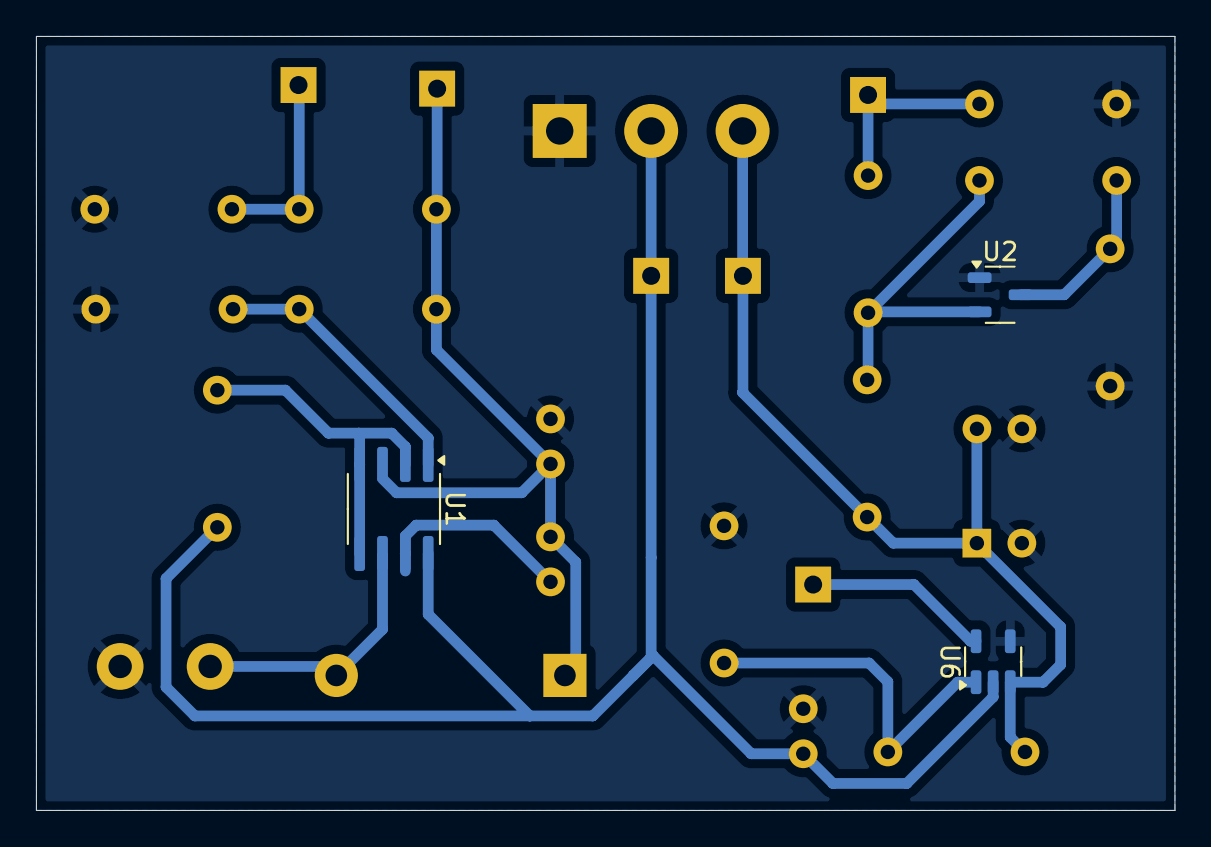
[picture p81: board pcb_support.kicad_pcb from below]

Board: 2 copper layers, 63.2 x 43.0 mm, 29 parts (3 on the bottom side), 14 nets.

Parts:
C1, C3: 100µ; C_Disc_D3.4mm_W2.1mm_P2.50mm
C2: 1.5n; C_Disc_D3.4mm_W2.1mm_P2.50mm
C4: 10µ; CP_Radial_D5.0mm_P2.50mm
C5: 100n; C_Disc_D3.4mm_W2.1mm_P2.50mm
D1: RBQ20T45ANZ; D_DO-27_P12.70mm_Horizontal
J1: Conn_01x03_Socket; TerminalBlock_bornier-3_P5.08mm
L1: 90µ; L_Radial_D9.5mm_P5.00mm_Fastron_07HVP
R1: 0.22; R_Axial_DIN0207_L6.3mm_D2.5mm_P7.62mm_Horizontal
R2: 8.2k; R_Axial_DIN0207_L6.3mm_D2.5mm_P7.62mm_Horizontal
R3: 953; R_Axial_DIN0207_L6.3mm_D2.5mm_P7.62mm_Horizontal
R4: 1k; R_Axial_DIN0207_L6.3mm_D2.5mm_P7.62mm_Horizontal
R5: 1.1k; R_Axial_DIN0207_L6.3mm_D2.5mm_P7.62mm_Horizontal
R11: 10k; R_Axial_DIN0207_L6.3mm_D2.5mm_P7.62mm_Horizontal
R12: 11.24k; R_Axial_DIN0207_L6.3mm_D2.5mm_P7.62mm_Horizontal
RA1: 10; R_Axial_DIN0207_L6.3mm_D2.5mm_P7.62mm_Horizontal
RB1: 100k; R_Axial_DIN0207_L6.3mm_D2.5mm_P7.62mm_Horizontal
RO1: 1.5k; R_Axial_DIN0207_L6.3mm_D2.5mm_P7.62mm_Horizontal
RO2: 1.4k; R_Axial_DIN0207_L6.3mm_D2.5mm_P7.62mm_Horizontal
RS1: 1k; R_Axial_DIN0207_L6.3mm_D2.5mm_P7.62mm_Horizontal
TP1, TP2, TP3, TP4, TP5, TP6: TestPoint; TestPoint_THTPad_2.0x2.0mm_Drill1.0mm
U1: MC33063A-Q1_TRANS; SOIC-8_3.9x4.9mm_P1.27mm
U2: TL431; SOT-23-3
U6: TLV3201; SOT-23-5

Connections:
0: C1.2, C3.2, C4.2, C5.2, J1.1, L1.2, R2.2, R5.1, R12.1, RB1.2, RO2.2, U2.1 (2), U6.4 (GND)
-VPOSA: R4.1, R5.2, TP5.1
-Vbat: C2.2, C3.1, D1.1 (+), R3.1, R4.2, TP4.1, U1.3 (GND)
unnamed: D1.2 (-), L1.1, U1.6 (SE)
unnamed: R2.1, R3.2, U1.1 (CII)
unnamed: R1.1, U1.2 (DC), U1.4 (Ipk), U1.5 (SC)
unnamed: C2.1, U1.7 (TC)
unnamed: RA1.2, RB1.1, U2.3 (1)
unnamed: RA1.1, RO1.1, RS1.2, U2.2 (3)
unnamed: R11.1, R12.2, U6.1 (IN+)
Vbat: C4.1, C5.1, J1.3, R11.2, RS1.1, TP2.1, U6.3 (Vcc)
Vbuck: C1.1, J1.2, R1.2, TP6.1, U1.8 (VCC), U6.2 (IN-)
Venable: TP3.1, U6.5 (OUT)
Vref: RO1.2, RO2.1, TP1.1
