DeniseViltes/dce-g5-proyecto_integrador/Checkpoint 4/PWM/pcb_pwm/pcb_pwm.kicad_pcb

## KiCad design Checkpoint 4/PWM/pcb_pwm/pcb_pwm.kicad_pcb (2024-11-30)

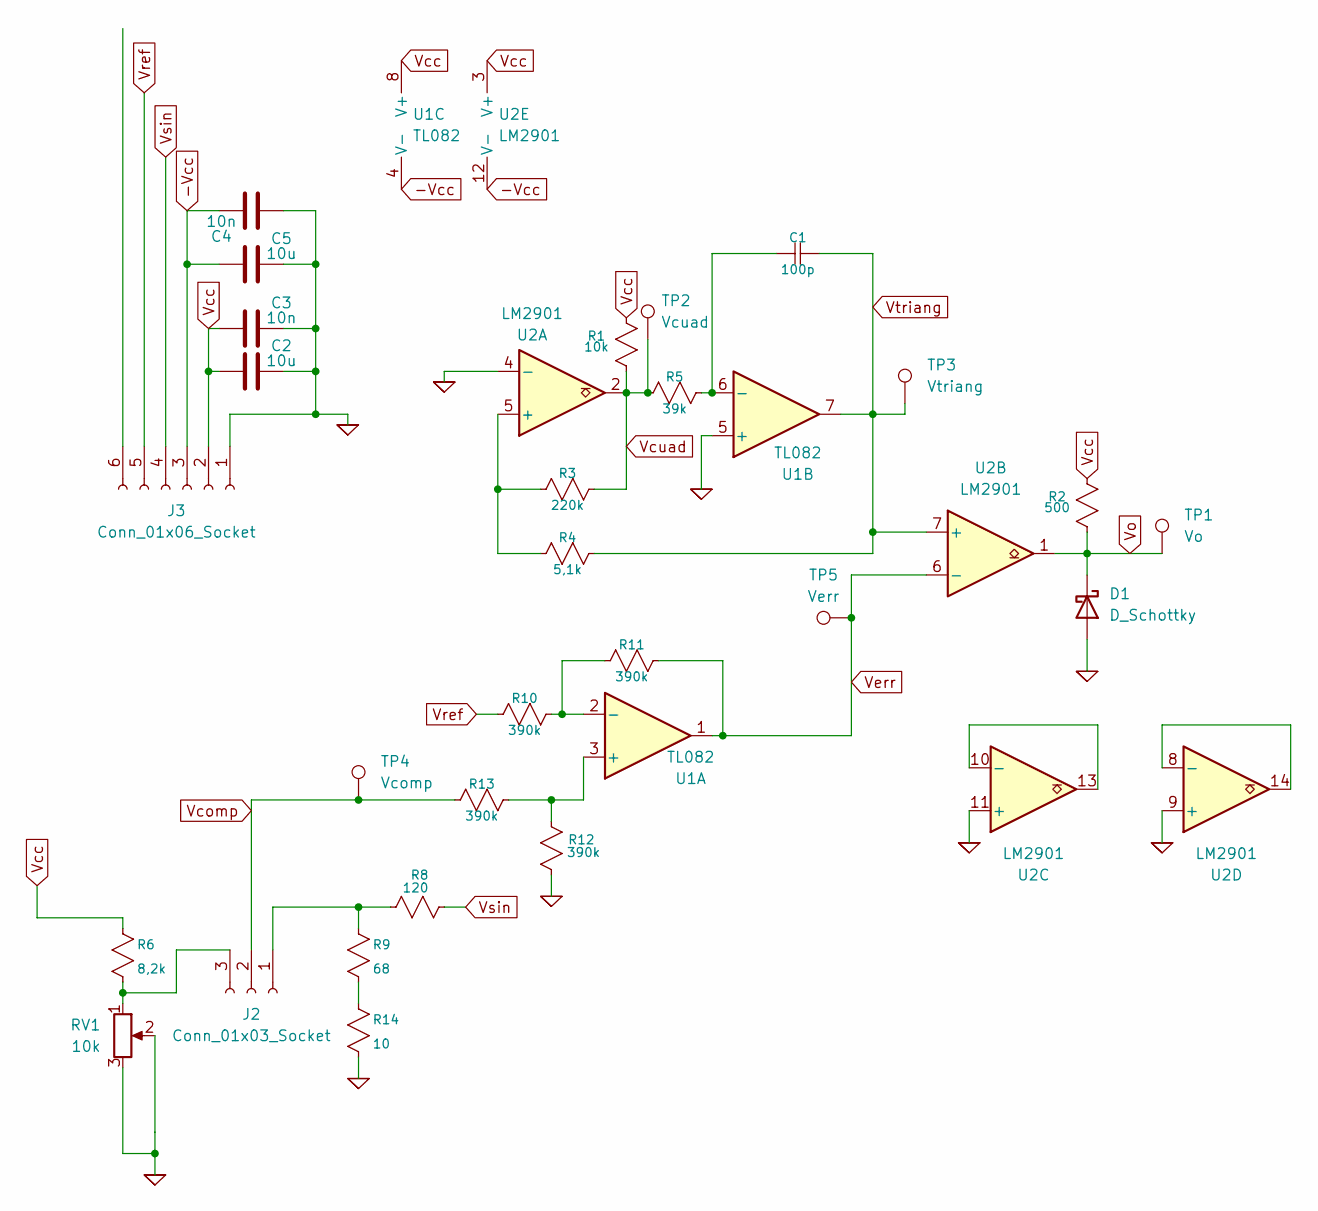
[picture p82: schematic pcb_pwm.kicad_sch]

Parts:
C1: 100p; C_Disc_D3.4mm_W2.1mm_P2.50mm
C2, C5: 10u; CP_Radial_D5.0mm_P2.50mm
C3, C4: 10n; C_Disc_D4.3mm_W1.9mm_P5.00mm
D1: D_Schottky; TO-220-2_Vertical
J2: Conn_01x03_Socket; PinHeader_1x03_P2.54mm_Vertical
J3: Conn_01x06_Socket; TerminalBlock_bornier-6_P5.08mm
R1: 10k; R_Axial_DIN0207_L6.3mm_D2.5mm_P7.62mm_Horizontal
R2: 500; R_Axial_DIN0207_L6.3mm_D2.5mm_P7.62mm_Horizontal
R3: 220k; R_Axial_DIN0207_L6.3mm_D2.5mm_P7.62mm_Horizontal
R4: 5,1k; R_Axial_DIN0207_L6.3mm_D2.5mm_P7.62mm_Horizontal
R5: 39k; R_Axial_DIN0207_L6.3mm_D2.5mm_P7.62mm_Horizontal
R6: 8,2k; R_Axial_DIN0207_L6.3mm_D2.5mm_P7.62mm_Horizontal
R8: 120; R_Axial_DIN0207_L6.3mm_D2.5mm_P7.62mm_Horizontal
R9: 68; R_Axial_DIN0207_L6.3mm_D2.5mm_P7.62mm_Horizontal
R10, R11, R12, R13: 390k; R_Axial_DIN0207_L6.3mm_D2.5mm_P7.62mm_Horizontal
R14: 10; R_Axial_DIN0207_L6.3mm_D2.5mm_P7.62mm_Horizontal
RV1: 10k; Potentiometer_Piher_PC-16_Single_Horizontal
TP1: Vo; TestPoint_THTPad_1.3x1.3mm_Drill0.7mm
TP2: Vcuad; TestPoint_THTPad_1.3x1.3mm_Drill0.7mm
TP3: Vtriang; TestPoint_THTPad_1.3x1.3mm_Drill0.7mm
TP4: Vcomp; TestPoint_THTPad_1.3x1.3mm_Drill0.7mm
TP5: Verr; TestPoint_THTPad_1.3x1.3mm_Drill0.7mm
U1: TL082; DIP-8_W7.62mm_Socket
U2: LM2901; DIP-14_W7.62mm_Socket

Connections:
0: C2.2, C3.2, C4.1, C5.2, D1.2 (A), J3.1, R12.2, R14.2, RV1.2, RV1.3, U1.5 (+), U2.4 (-), U2.9 (+), U2.11 (+)
-Vcc: C4.2, C5.1, J3.3, U1.4 (V-), U2.12 (V-)
unnamed: J2.1, R8.1, R9.1
unnamed: J2.3, R6.2, RV1.1
unnamed: R9.2, R14.1
unnamed: R12.1, R13.1, U1.3 (+)
unnamed: R10.1, R11.2, U1.2 (-)
unnamed: C1.2, R5.1, U1.6 (-)
unnamed: R3.2, R4.2, U2.5 (+)
unnamed: U2.10 (-), U2.13
unnamed: U2.8 (-), U2.14
Vcc: C2.1, C3.1, J3.2, R1.2, R2.2, R6.1, U1.8 (V+), U2.3 (V+)
Vcomp: J2.2, R13.2, TP4.1
Vcuad: R1.1, R3.1, R5.2, TP2.1, U2.2
Verr: R11.1, TP5.1, U1.1, U2.6 (-)
Vo: D1.1 (K), R2.1, TP1.1, U2.1
Vref: J3.5, R10.2
Vsin: J3.4, R8.2
Vtriang: C1.1, R4.1, TP3.1, U1.7, U2.7 (+)

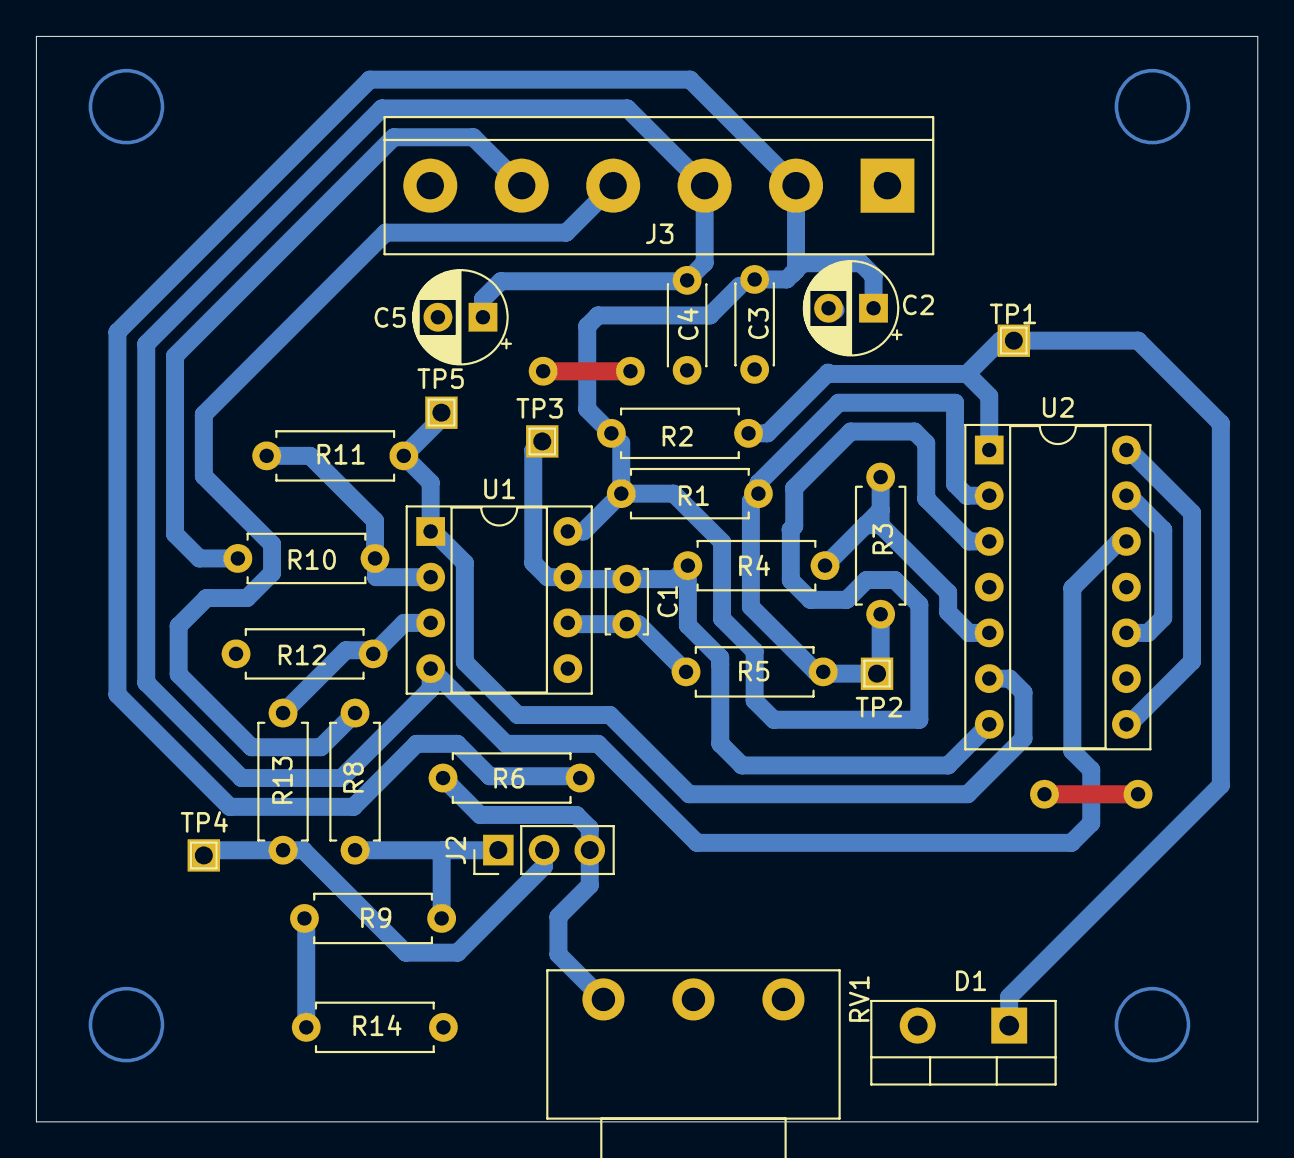
[picture p83: board pcb_pwm.kicad_pcb from above]

Board: 2 copper layers, 67.8 x 60.3 mm, 29 parts (0 on the bottom side), 19 nets.
