DeniseViltes/dce-g5-proyecto_integrador/Checkpoint 4/Buck/pcb_buck/pcb_buck.kicad_pcb

## KiCad design Checkpoint 4/Buck/pcb_buck/pcb_buck.kicad_pcb (2024-11-30)

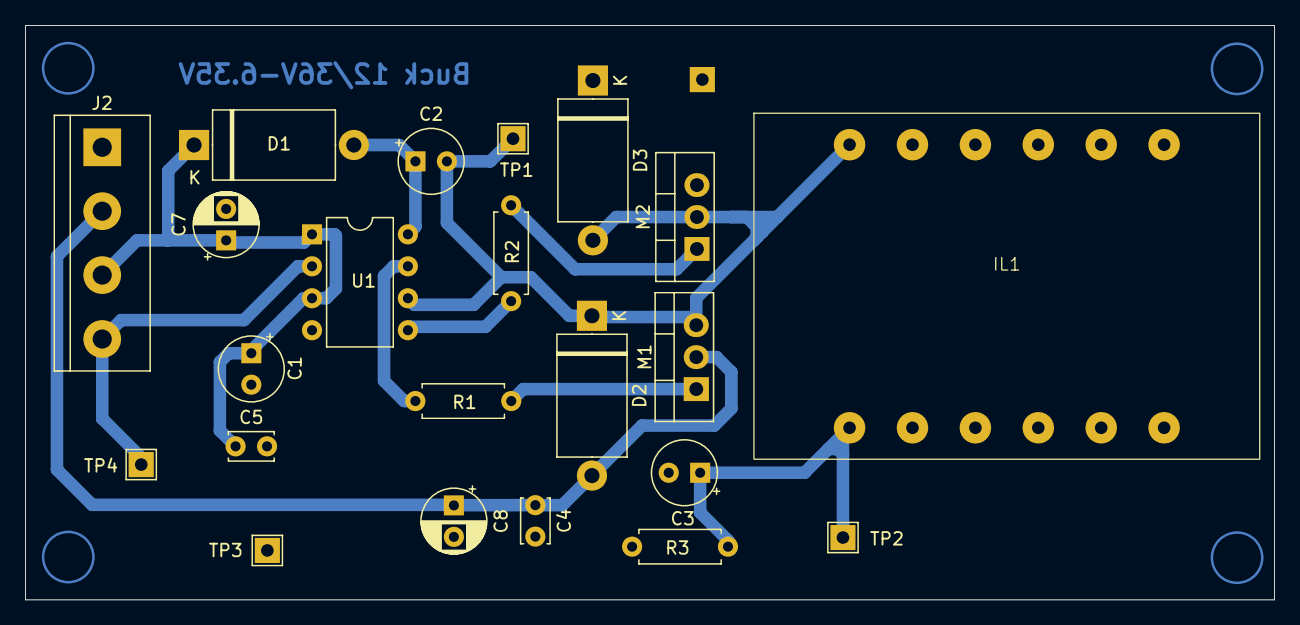
[picture p84: board pcb_buck.kicad_pcb from above]

Board: 2 copper layers, 99.3 x 45.6 mm, 22 parts (0 on the bottom side), 11 nets.

Parts:
C1: 1µ; CP_Radial_Tantal_D5.0mm_P2.50mm
C2: 330n; CP_Radial_Tantal_D5.0mm_P2.50mm
C3: 150n; CP_Radial_Tantal_D5.0mm_P2.50mm
C4, C5: 100n; C_Disc_D3.4mm_W2.1mm_P2.50mm
C7, C8: 10u; CP_Radial_D5.0mm_P2.50mm
D1, D2, D3: D1n5822rl; D_DO-27_P12.70mm_Horizontal
IL1: 700µ; Inductor
J2: Conn_01x04_Socket; TerminalBlock_bornier-4_P5.08mm
M1, M2: IRLZ44N; TO-220-3_Vertical
R1, R2: 10; R_Axial_DIN0207_L6.3mm_D2.5mm_P7.62mm_Horizontal
R3: 390; R_Axial_DIN0207_L6.3mm_D2.5mm_P7.62mm_Horizontal
TP1: Vd; TestPoint_THTPad_2.0x2.0mm_Drill1.0mm
TP2: Vo; TestPoint_THTPad_2.0x2.0mm_Drill1.0mm
TP3: GND; TestPoint_THTPad_2.0x2.0mm_Drill1.0mm
TP4: PWM; TestPoint_THTPad_2.0x2.0mm_Drill1.0mm
U1: IR2104; DIP-8_W7.62mm

Connections:
0: C1.2, C3.2, C4.2, C5.2, C7.2, C8.2, D3.1 (+), J2.1, M2.3 (S), R3.2, TP3.1, U1.4 (COM)
unnamed: C2.1, D1.2 (-), U1.8 (LO)
unnamed: M1.1 (D), R1.1
unnamed: M2.1 (D), R2.1
unnamed: R1.2, U1.7 (VS)
unnamed: R2.2, U1.5 (VB)
Vd: C2.2, D2.1 (+), D3.2 (-), IL1.7, M1.3 (S), M2.2 (G), TP1.1, U1.6 (HO)
Vo: C3.1, IL1.1, R3.1, TP2.1
pwm: J2.4, TP4.1, U1.2 (IN)
vcc: C1.1, C5.1, C7.1, D1.1 (+), J2.3, U1.1 (VCC), U1.3 (NSD)
vdd: C4.1, C8.1, D2.2 (-), J2.2, M1.2 (G)
