DeniseViltes/dce-g5-proyecto_integrador/Checkpoint 2/DCE - PCB - v1/dce-pcb-v1.kicad_pcb

## KiCad design Checkpoint 2/DCE - PCB - v1/dce-pcb-v1.kicad_pcb (2024-11-08)

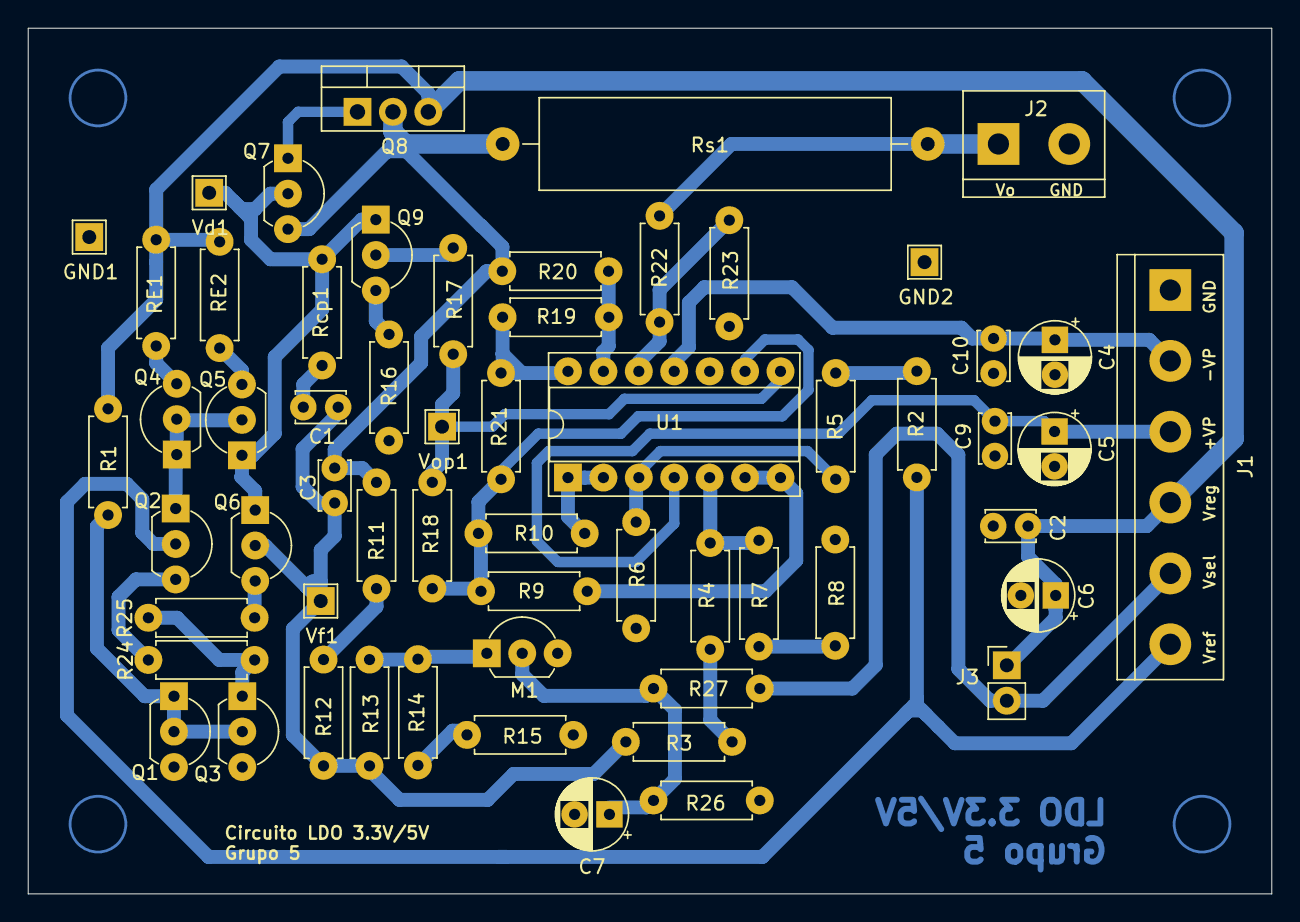
[picture p85: board dce-pcb-v1.kicad_pcb from above]

Board: 2 copper layers, 89.2 x 62.1 mm, 59 parts (0 on the bottom side), 37 nets.

Parts:
C1: 2.2n; C_Disc_D3.4mm_W2.1mm_P2.50mm
C2, C9, C10: 10n; C_Disc_D3.4mm_W2.1mm_P2.50mm
C3: 100p; C_Disc_D3.4mm_W2.1mm_P2.50mm
C4, C5, C6: 10u; CP_Radial_D5.0mm_P2.50mm
C7: C; CP_Radial_D5.0mm_P2.50mm
GND1, GND2: TestPoint; TestPoint_THTPad_2.0x2.0mm_Drill1.0mm
J1: Conn_01x06_Socket; TerminalBlock_bornier-6_P5.08mm
J2: Conn_01x02_Socket; TerminalBlock_bornier-2_P5.08mm
J3: Conn_01x02_Socket; PinHeader_1x02_P2.54mm_Vertical
M1: 2N7000; TO-92L_Inline_Wide
Q1, Q2, Q3, Q6, Q9: BC547B; TO-92L_Inline_Wide
Q4, Q5: BC557B; TO-92L_Inline_Wide
Q7: TIP41C; TO-92L_Inline_Wide
Q8: TIP42C; TO-220-3_Vertical
R1: 3.3k; R_Axial_DIN0207_L6.3mm_D2.5mm_P7.62mm_Horizontal
R2: 5.6k; R_Axial_DIN0207_L6.3mm_D2.5mm_P7.62mm_Horizontal
R3, R7: 6.8k; R_Axial_DIN0207_L6.3mm_D2.5mm_P7.62mm_Horizontal
R4: 1.2k; R_Axial_DIN0207_L6.3mm_D2.5mm_P7.62mm_Horizontal
R5, R11: 2.7k; R_Axial_DIN0207_L6.3mm_D2.5mm_P7.62mm_Horizontal
R6, R9, R10, R21: 1.5k; R_Axial_DIN0207_L6.3mm_D2.5mm_P7.62mm_Horizontal
R8: 510; R_Axial_DIN0207_L6.3mm_D2.5mm_P7.62mm_Horizontal
R12: 390; R_Axial_DIN0207_L6.3mm_D2.5mm_P7.62mm_Horizontal
R13: 1K; R_Axial_DIN0207_L6.3mm_D2.5mm_P7.62mm_Horizontal
R14: 680; R_Axial_DIN0207_L6.3mm_D2.5mm_P7.62mm_Horizontal
R15: 270; R_Axial_DIN0207_L6.3mm_D2.5mm_P7.62mm_Horizontal
R16: 100; R_Axial_DIN0207_L6.3mm_D2.5mm_P7.62mm_Horizontal
R17, R20, R22, R26, R27: 1k; R_Axial_DIN0207_L6.3mm_D2.5mm_P7.62mm_Horizontal
R18: 100k; R_Axial_DIN0207_L6.3mm_D2.5mm_P7.62mm_Horizontal
R19, R23: 10k; R_Axial_DIN0207_L6.3mm_D2.5mm_P7.62mm_Horizontal
R24, R25: 10; R_Axial_DIN0207_L6.3mm_D2.5mm_P7.62mm_Horizontal
RE1, RE2: 470; R_Axial_DIN0207_L6.3mm_D2.5mm_P7.62mm_Horizontal
Rcp1: 220; R_Axial_DIN0207_L6.3mm_D2.5mm_P7.62mm_Horizontal
Rs1: 0.1; R_Axial_Power_L25.0mm_W6.4mm_P30.48mm
U1: LM324; DIP-14_W7.62mm_Socket
Vd1: TestPoint; TestPoint_THTPad_2.0x2.0mm_Drill1.0mm
Vf1: TestPoint; TestPoint_THTPad_2.0x2.0mm_Drill1.0mm
Vop1: TestPoint; TestPoint_THTPad_2.0x2.0mm_Drill1.0mm

Connections:
0: C2.2, C4.2, C5.2, C6.2, C7.2, C9.2, C10.2, GND1.1, GND2.1, J1.1, J2.2, M1.3 (S), Q1.3 (E), Q3.3 (E), R6.2, R8.2, R15.2, R16.2, R23.2, R26.2, U1.10 (+)
/+VPOSA: C5.1, C9.1, J1.3, U1.4 (V+)
/-VPOSA: C4.1, C10.1, J1.2, U1.11 (V-)
/Sum: R9.1, R10.1, R18.1, R21.2, U1.9 (-)
/Vf: C1.2, C3.2, Q6.2 (B), R3.2, R12.2, R13.1, Vf1.1
/Vlc: Q5.1 (C), Q6.1 (C), Q7.2 (B), Q9.1 (C), Rcp1.1, Vd1.1
/Vo: J2.1, R22.1, Rs1.1
/Vref: J1.6, Q2.2 (B), R2.2
/Vreg: C2.1, C6.1, J1.4, J3.1, Q8.3 (E), R1.1, RE1.1, RE2.1
/Vsel: J1.5, J3.2, R27.2
unnamed: C1.1, Rcp1.2
unnamed: M1.1 (D), R13.2, R14.1
unnamed: C7.1, M1.2 (G), R26.1, R27.1
unnamed: Q1.1 (C), Q1.2 (B), Q3.2 (B), R1.2
unnamed: Q2.1 (C), Q4.1 (C), Q4.2 (B), Q5.2 (B)
unnamed: Q2.3 (E), R24.1
unnamed: Q3.1 (C), R24.2, R25.1
unnamed: Q4.3 (E), RE1.2
unnamed: Q5.3 (E), RE2.2
unnamed: Q6.3 (E), R25.2
unnamed: Q7.1 (C), Q8.1 (C)
unnamed: C3.1, Q7.3 (E), Q8.2 (B), R11.1, R20.1, Rs1.2
unnamed: Q9.2 (B), R17.2
unnamed: Q9.3 (E), R16.1
unnamed: R2.1, R5.2
unnamed: R3.1, R4.2
unnamed: R7.2, R8.1
unnamed: R11.2, R12.1
unnamed: R14.2, R15.1
unnamed: R17.1, R18.2, U1.8, Vop1.1
unnamed: R19.2, R21.1, U1.14
unnamed: R5.1, R6.1, U1.3 (+)
unnamed: R10.2, U1.1, U1.2 (-)
unnamed: R4.1, R7.1, U1.5 (+)
unnamed: R9.2, U1.6 (-), U1.7
unnamed: R22.2, R23.1, U1.12 (+)
unnamed: R19.1, R20.2, U1.13 (-)
