DeniseViltes/dce-g5-proyecto_integrador/(commit log)

2024-08-30 agrega el gitignore
2024-08-30 agrega el enunciado
2024-08-31 subo el ltspice
2024-09-06 sube primer intento de simulación
2024-09-06 Sube las hojas de datos del transistor de paso
2024-09-07 agrega los cambios de la clase 9/6, ver comentarios en el archivo de spice
    [pcb.kicad_pcb, pcb.kicad_sch]
2024-09-07 sube últimos comentarios sobre la simulación
2024-09-07 agrega archivo de pruebas de fuente de corriente
2024-09-07 elimina archivo de simulacion viejo
2024-09-07 funciona la configuración básica
2024-09-08 Nueva versión del circuito 07/09
2024-09-09 Versión 5 de la simulación - Ahora funciona :D
2024-09-11 sube todos para poder mergear
2024-09-11 Elimino archivos extras de spice
2024-09-12 sube datashets y sube primer intento con kicad, hay que cambiar los operaciones y vincularlos con un pin, lo mismo con las fuentes
    [dce-pcb.kicad_pcb, dce-pcb.kicad_sch]
2024-09-13 Update Simulacion - v.6.asc
    separa en bloques los opamps para facilitar pasarlo a kicad
2024-09-13 sube el esquematico del pcb
    [dce-pcb-v1.kicad_pcb, dce-pcb-v1.kicad_sch, dce-pcb.kicad_pcb, dce-pcb.kicad_sch]
2024-09-13 actualiza el pcb
    [dce-pcb-v1.kicad_pcb, dce-pcb-v1.kicad_sch]
2024-09-15 Version 10 de la simulacion
2024-09-20 sube simulación de lazo de ganancia
2024-09-22 Un poco mas ordenado
    [dce-pcb-v1.kicad_pcb, dce-pcb-v1.kicad_sch]
2024-09-25 Empieza archivo de ploteo en python, y el nuevo esquemático del p
    [dce-pcb-v1.kicad_pcb, dce-pcb-v1.kicad_sch]
2024-09-25 sube primeros graficos en python
    arregla la corriente de foldback, pero se pasa de los 750mA
    Deja más linda la bornera del pcb
    Falta agregar test points en el pcb
2024-09-25 Simulacion final de lazos de tension y corriente
2024-09-25 Ahora si valores finales comerciales de las compensaciones de lazo
2024-09-25 Nuevos valores de R para el foldback
2024-09-25 Sube esquematico y diseño del pcb actualizados
    Falta organizar el pcb
    [dce-pcb-v1.kicad_pcb]
2024-09-25 avance pcb
    [dce-pcb-v1.kicad_pcb, dce-pcb-v1.kicad_sch]
2024-09-27 Actualizacion PCB
    [dce-pcb-v1.kicad_pcb, dce-pcb-v1.kicad_sch]
2024-09-27 Sube curvas basicas
    foldback
    potencia
    recta de carga
    recta de linea
2024-09-27 valor de R de compensacion actualizado
2024-09-27 Sube lgraficos del lazo de tension sin compensar para varias RL
2024-09-27 Sube todas las simulaciones de ganancia de lazo
2024-09-28 arregla los grafiquitos de los bodes
2024-09-29 PCB actualizado
    [dce-pcb-v1.kicad_pcb, dce-pcb-v1.kicad_sch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]
2024-09-29 valor de resistencia de compensacion corregida en el esquematico
    [dce-pcb-v1.kicad_sch]
2024-09-30 sube listita de compras
2024-10-01 pcb actualizado con recomendaciones de julio
    [dce-pcb-v1.kicad_pcb, dce-pcb-v1.kicad_sch]
2024-10-05 ojala no rompa todo
    [dce-pcb-v1.kicad_pcb, dce-pcb-v1.kicad_sch]
2024-10-06 nuevo pcb
    [dce-pcb-v1.kicad_pcb]
2024-10-13 probando cosas en el readme
2024-10-18 sube primeros graficos de las mediciones
    [regDeLinea.xlsx]
2024-10-28 actualiza spice con los cambios en el pcb
    [333.csv, 555.csv, cargadinamica3.csv, cargadinamica3.xlsx, cargadinamica5.csv, cargadinamica5.xlsx, dce-pcb-v1.kicad_sch, potencia.xlsx]
2024-10-30 sube los resultados de los componentes calculados
2024-10-31 sube cuentitas del buck sin realimentar?
    igual no queda tan bien siguiendo las cuentas del Lcr, pero supongo que es porque me falta definir cual es la Iout
2024-11-06 PWM v1
2024-11-07 v1 buck
2024-11-07 Falta Pensar donde cambiaría con la realiment
2024-11-07 Ahi funciona el integrado, pero vo da cualquier cosa
2024-11-08 Sube buck
2024-11-08 sube buck con valores comerciales de R y C
2024-11-08 PWM cocinadito
2024-11-08 Revert "PWM cocinadito"
    This reverts commit b6f61ffd52ceb4e050fefbf99fd4870990937637.
2024-11-08 PWM listo, pensar donde realimentar
2024-11-08 pcb buck
    [pcb_buck.kicad_pcb, pcb_buck.kicad_sch, pcb_pwm.kicad_pcb, pcb_pwm.kicad_sch]
2024-11-08 sube de todo
2024-11-08 pcb pwm
    [pcb_buck.kicad_pcb, pcb_pwm.kicad_pcb, pcb_pwm.kicad_sch]
2024-11-08 sube ultimo intento buck
2024-11-10 ultima version
    [tlv3201.dsn, tlv3201.opj]
2024-11-15 sube pwm coke
2024-11-15 pcb pwm final?
    [pcb_pwm.kicad_pcb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]
2024-11-16 cambios finales cp4
    [pcb_buck.kicad_pcb, pcb_buck.kicad_sch, pcb_pwm.kicad_pcb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]
2024-11-17 Actualiza los datasheets que faltan
2024-11-17 Arregla problemas de símbolos en el buck
2024-11-17 Arregla problemas de símbolos en el pwm
2024-11-17 Arregla problemas de símbolos en el support
2024-11-18 creo que ahora si arregla el error de las librerias
2024-11-19 sube buck a lazo cerrado
    [pcb_buck.kicad_sch]
2024-11-21 Buck lazo cerrado sin Diodo yet
2024-11-22 PCB Buck new
    [pcb_buck.kicad_pcb, pcb_buck.kicad_sch]
2024-11-23 sube cambios en el pcb del pwm, y cambios pruebas en la simu del buck
    [pcb_pwm.kicad_pcb, pcb_pwm.kicad_sch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]
2024-11-23 agrega ultimos cambios al pcb pwm?
    [pcb_pwm.kicad_pcb]
2024-11-23 ahora está más lindo
    [pcb_pwm.kicad_pcb]
2024-11-23 pcb pwm y buck final
    [pcb_buck.kicad_pcb, pcb_pwm.kicad_pcb, pcb_pwm.kicad_sch]
2024-11-30 a ver si ahora si funcan los pcb sino me mato
    [pcb_buck.kicad_pcb, pcb_buck.kicad_sch, pcb_pwm.kicad_pcb, pcb_pwm.kicad_sch]
2024-12-04 pcb support
    [pcb_support.kicad_pcb, pcb_support.kicad_sch]
2024-12-06 sube un monton de cosas
    [rtaFreq.xlsx]
2024-12-06 agrega los archivos de compensacion
2024-12-06 sube pruebas de compensacion
    [duty.xlsx, rectaCarga.xlsx, rectaLinea.xlsx, rtaFreq.xlsx]
2024-12-06 sube ultimos cambios e informe final
    [duty.xlsx, rtaFreq.xlsx]
